F-Wilke/TekadeCarPhone/7SegFootprint.JPG

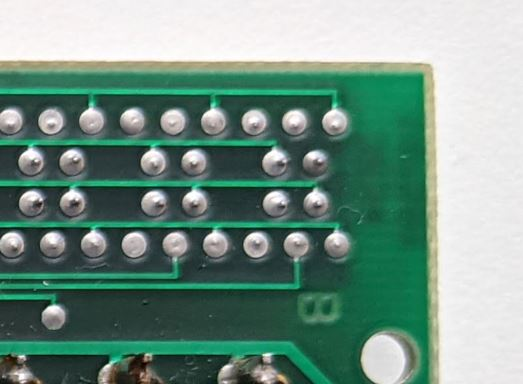
7SegFootprint.JPG
