F-Wilke/TekadeCarPhone/LayoutBM83.PNG

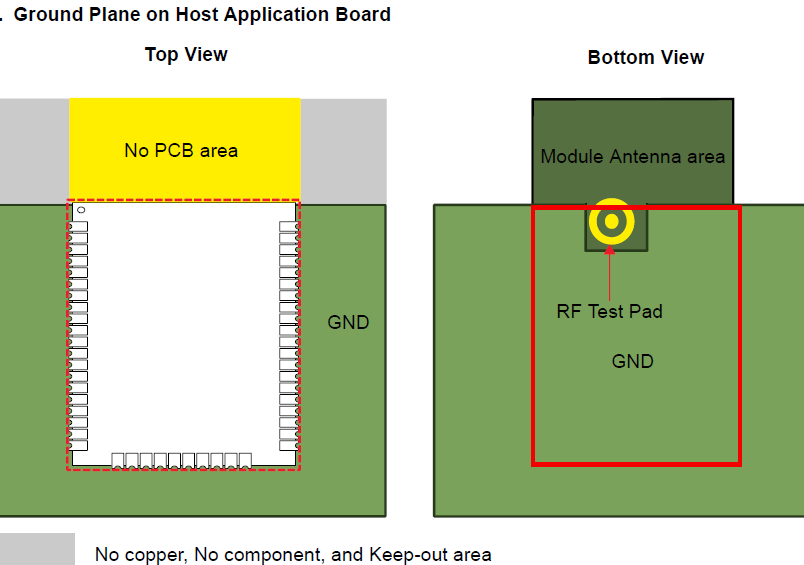
LayoutBM83.PNG
