F-Wilke/TekadeCarPhone/LayoutLM53635.PNG

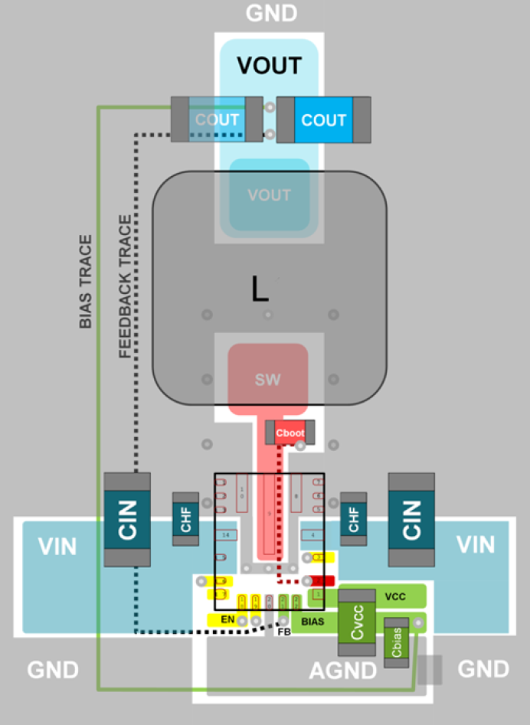
LayoutLM53635.PNG
