F-Wilke/TekadeCarPhone/LayoutLM74610.PNG

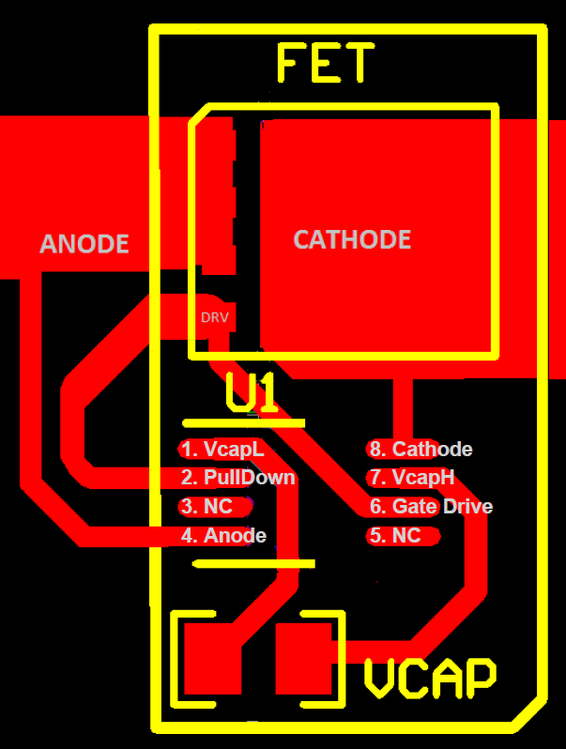
LayoutLM74610.PNG
