F-Wilke/TekadeCarPhone/LayoutTPS57114.PNG

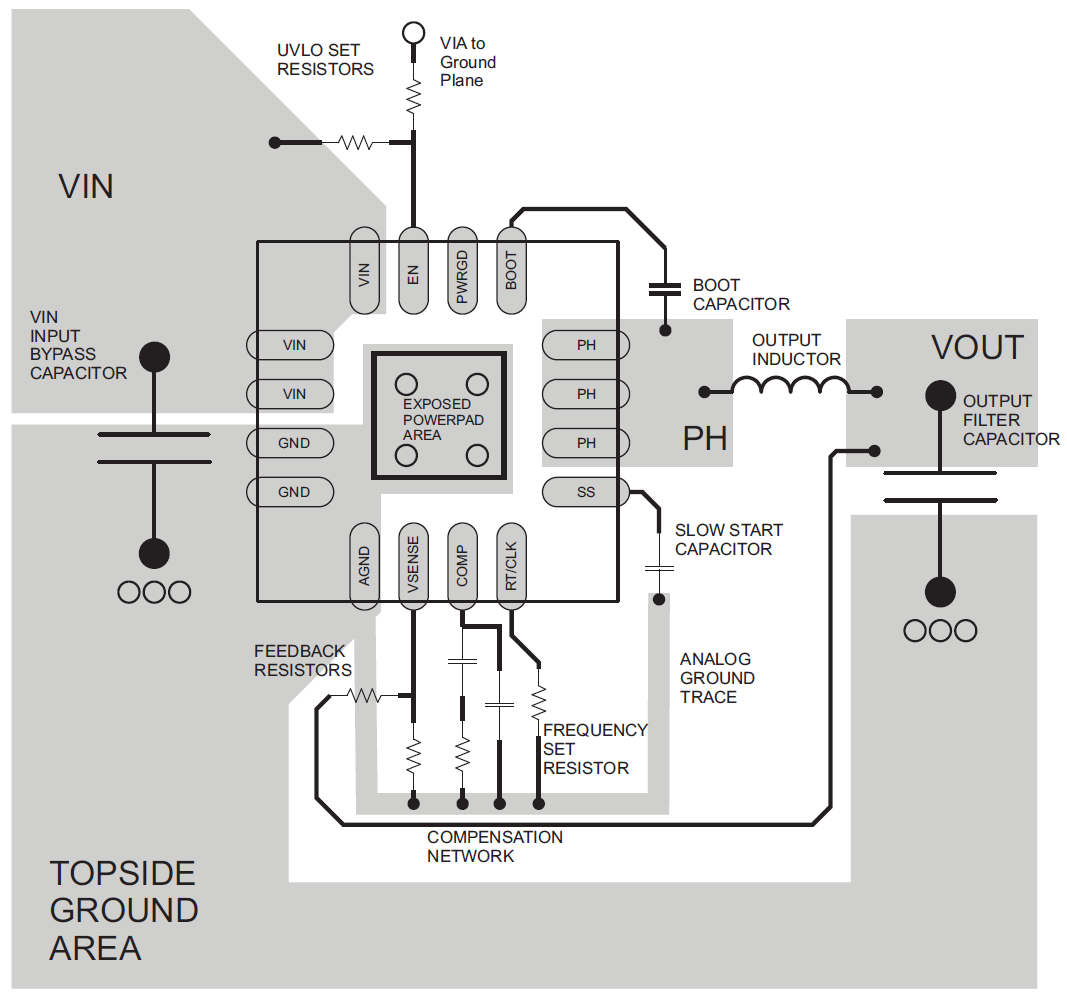
LayoutTPS57114.PNG
