F-Wilke/TekadeCarPhone/LayoutTPS62293.PNG

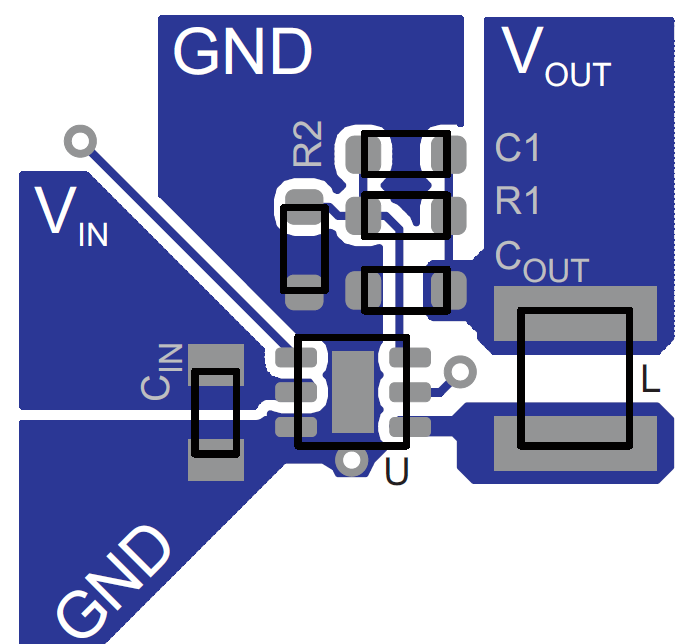
LayoutTPS62293.PNG
