F-Wilke/TekadeCarPhone/LDR_LED_UIBoard.png

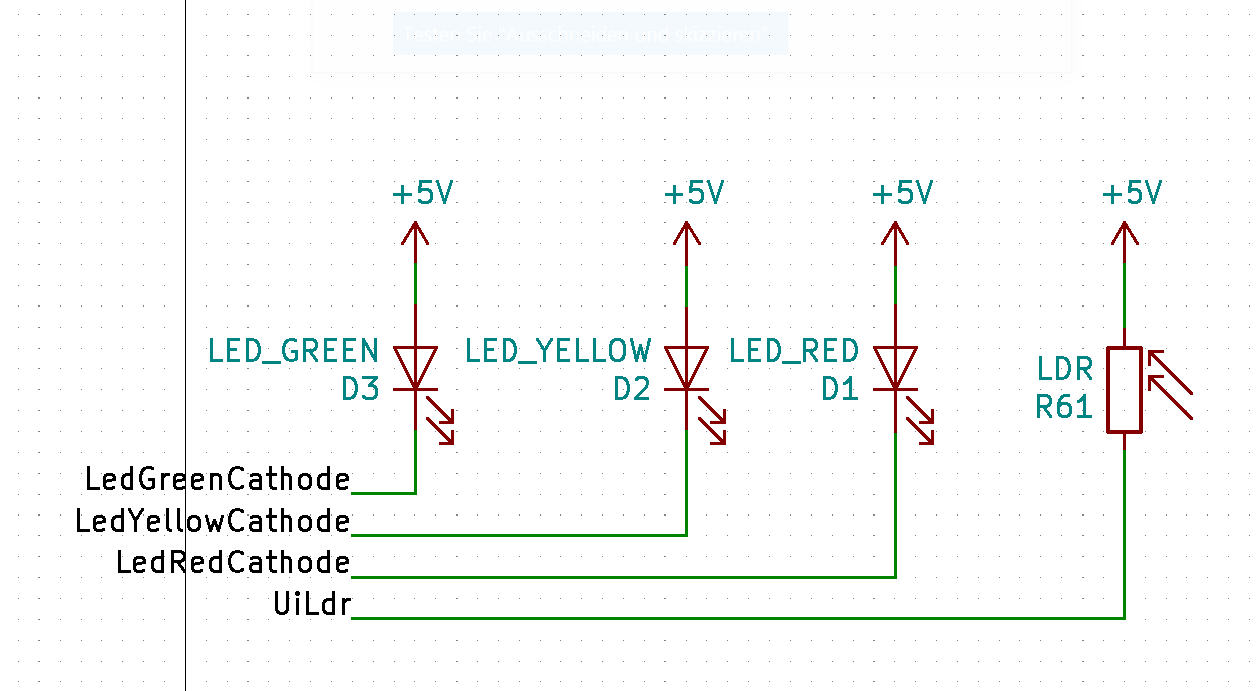
LDR_LED_UIBoard.png
