F-Wilke/TekadeCarPhone/RUNPG_GLOBALEN.JPG

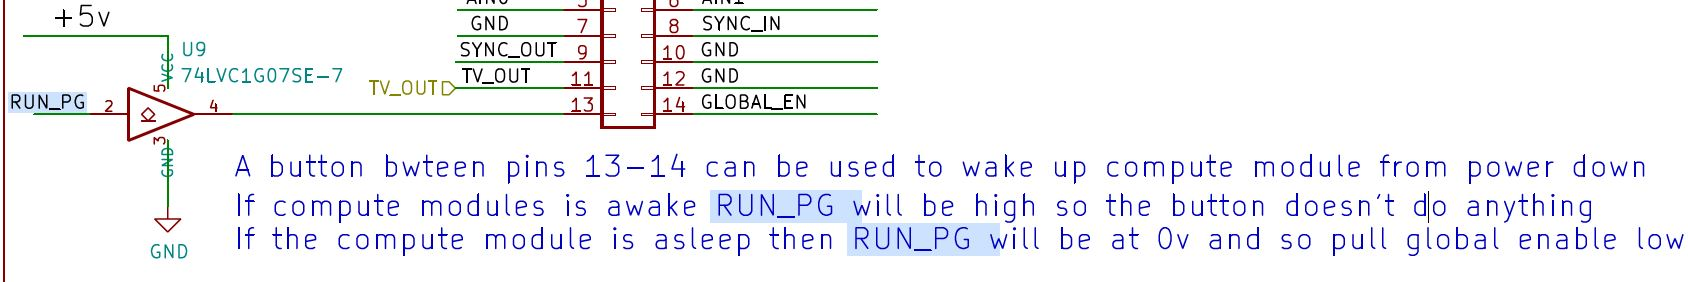
RUNPG_GLOBALEN.JPG
