F-Wilke/TekadeCarPhone/BOM/20220322 BOM TeKaDe Baseboard 5VEXT BM64.xlsx

Sheet: Vollständig
 |  |  |  |  |  |  |  |  | MOUSER |  |  |  | Gesamtpreis
Item | Qty | Description | Reference | Mfr | Mfr P/N | Case | Height | Qualification | Artikelnr | Available | 10er Preis | 1000er Preis | 10er | 1000er
1 | 1 | 4u7/16V/X7R/10% | C1 | Taiyo Yuden | EMK212AB7475KGHT | 805 |  | AEC-Q200 | 963-EMK212AB7475KGHT | 100k | 0.15 € | 0.06 € | 0.15 € | 0.06 €
2 | 17 | 100n/16V/X7R/10% | C2-C5, C10, C31-C33, C38, C40, C42, C71, C72, C74, C75, C77, C78 | WE | 885012205037 | 402 |  |  | 710-885012205037 | 196K | 0.02 € | 0.01 € | 0.29 € | 0.24 €
3 | 4 | 4n7/100V/X7R/10% | C6-C9 | Samsung | CL21B472KDCNNNC | 805 |  |  | 187-CL21B472KDCNNNC | 343k | 0.04 € | 0.03 € | 0.14 € | 0.13 €
4 | 4 | 10u/50V/X7R/10% | C13, C14, C18, C19 | Samsung | CL32B106KBJNNNF | 1210 |  |  | 187-CL32B106KBJNNNF | 1100 | 0.36 € | 0.18 € | 1.44 € | 0.70 €
5 | 2 | 1n/100V/X7R/10% | C15, C17 | Samsung | CL10B102KC8NNNC | 603 |  |  | 187-CL10B102KC8NNNC | 20k | 0.02 € | 0.01 € | 0.04 € | 0.02 €
6 | 1 | 220u/25V/POL/20% | C20 | KEMET | ESL227M035AG8AA | D8 x 3,5 Pin |  |  | 80-ESL227M035AG8AA | 825 | 0.19 € | 0.12 € | 0.19 € | 0.12 €
7 | 2 | 47u/10V/X5R/20% | C34, C37 | Taiyo Yuden | LMK316ABJ476ML-T | 1206 |  |  | 963-LMK316ABJ476ML-T | 15K | 0.28 € | 0.15 € | 0.57 € | 0.31 €
8 | 2 | 22u/10V/X5R/20% | C35, C36 | Murata | GRM21BR61A226ME51L | 805 |  |  | 81-GRM21BR61A226ME1L | 1500K | 0.17 € | 0.07 € | 0.34 € | 0.13 €
9 | 0 | NA | C39 |  |  | 603 |  |  |  |  |  |  | 0.00 € | 0.00 €
10 | 1 | 10u/6V3/X5R/20% | C41 | Taiyo Yuden | JMK107ABJ106MAHT | 603 |  | AEC-Q200 | 963-JMK107ABJ106MAHT | 127k | 0.07 € | 0.04 € | 0.07 € | 0.04 €
11 | 10 | 10p/50V/C0G/5% | C46, C47, C50, C51, C55, C56, C60, C61, C66, C69 | KEMET | C0402C100J5GACAUTO7411 | 402 |  | AEC-Q200 | 80-C0402C100J5GAUTLR | 72K | 0.06 € | 0.20 € | 0.58 € | 2.00 €
12 | 19 | 1u/6V3/X5R/10% | C43-C45, C48, C49, C52-C54, C57-C59, C62, C64, C65, C67, C68, C70, C73, C76 | Taiyo Yuden | JMK105BJ105KVHF | 402 |  | AEC-Q200 | 963-JMK105BJ105KVHF | 360k | 0.03 € | 0.02 € | 0.53 € | 0.30 €
13 | 1 | 2u2/6V3/X5R/10% | C63 | Taiyo Yuden | LMK107BJ225KAHT | 603 |  | AEC-Q200 | 963-LMK107BJ225KAHT | 30k | 0.06 € | 0.02 € | 0.06 € | 0.02 €
14 | 4 | 150R/100mW/1% | R1, R2, R4, R5 | Yageo | AC0603FR-7W150RL | 603 |  | AEC-Q200 | 603-AC0603FR-7W150RL | 2K | 0.04 € | 0.02 € | 0.16 € | 0.06 €
15 | 1 | 10k/100mW/1% | R3 | Yageo | AC0603FR-1010KL | 603 |  | AEC-Q200 | 603-AC0603FR-1010KL | 270K | 0.02 € | 0.01 € | 0.02 € | 0.01 €
16 | 7 | 22k/62,5mA/1% | R6-R11, R13 | Yageo | AC0402FR-1322KL | 402 |  | AEC-Q200 | 603-AC0402FR-1322KL | 94K | 0.01 € | 0.004 € | 0.10 € | 0.03 €
17 | 1 | 100k/62,5mA/1% | R12 | Yageo | AC0402FR-13100KL | 402 |  | AEC-Q200 | 603-AC0402FR-13100KL | 56K | 0.02 € | 0.004 € | 0.02 € | 0.004 €
18 | 1 | 15k/62,5mA/1% | R14 | Yageo | AC0402FR-0715KL | 402 |  | AEC-Q200 | 603-AC0402FR-0715KL | 5K | 0.01 € | 0.004 € | 0.01 € | 0.004 €
19 | 1 | 100R/62,5mA/1% | R15 | Yageo | AC0402FR-13100RL | 402 |  | AEC-Q200 | 603-AC0402FR-13100RL | 7K | 0.01 € | 0.003 € | 0.01 € | 0.003 €
20 | 2 | 47k/62,5mA/1% | R16, R19 | Yageo | AC0402FR-0747KL | 402 |  | AEC-Q200 | 603-AC0402FR-0747KL | 4K | 0.01 € | 0.003 € | 0.03 € | 0.01 €
21 | 3 | 1k/100mW/1% | R17, R18, R30 | Yageo | AC0603FR-071KL | 603 |  | AEC-Q200 | 603-AC0603FR-071KL | 43K | 0.03 € | 0.004 € | 0.08 € | 0.01 €
22 | 1 | 68R/125mW/1% | R23 | Yageo | AC0805FR-0768RL | 805 |  | AEC-Q200 | 603-AC0805FR-0768RL | 5K | 0.03 € | 0.01 € | 0.03 € | 0.01 €
23 | 2 | 150R/125mW/1% | R24, R26 | Yageo | AC0805FR-07150RL | 805 |  | AEC-Q200 | 603-AC0805FR-07150RL | 9K | 0.04 € | 0.01 € | 0.07 € | 0.01 €
24 | 6 | 10k/62,5mA/1% | R20-R22, R25, R44, R45 | Yageo | AC0402FR-1310KL | 402 |  | AEC-Q200 | 603-AC0402FR-1310KL | 12K | 0.02 € | 0.004 € | 0.12 € | 0.02 €
25 | 1 | 360R/100mW/1% | R27 | Yageo | AC0603FR-07360RL | 603 |  | AEC-Q200 | 603-AC0603FR-07360RL | 865 | 0.03 € | 0.01 € | 0.03 € | 0.01 €
26 | 0 | NA | R31-R34 |  |  | 402 |  |  |  |  |  |  | 0.00 € | 0.00 €
27 | 0 | NA | R35, R36, R38 |  |  | 603 |  |  |  |  |  |  | 0.00 € | 0.00 €
28 | 3 | 0R | R37, R39, R49 | Yageo | AC0603FR-070RL | 603 |  | AEC-Q200 | 603-AC0603FR-070RL | 154K | 0.01 € | 0.004 € | 0.04 € | 0.01 €
29 | 4 | 2k2/62,5mA/1% | R40-R43 | Yageo | AF0402FR-072K2L | 402 |  | AEC-Q200 | 603-AF0402FR-072K2L | 30K | 0.06 € | 0.01 € | 0.22 € | 0.04 €
30 | 1 | 4k7/62,5mA/1% | R46 | Yageo | AC0402FR-134K7L | 402 |  | AEC-Q200 | 603-AC0402FR-134K7L | 71K | 0.02 € | 0.004 € | 0.02 € | 0.004 €
31 | 1 | 1M/62,5mA/1% | R47 | Yageo | AC0402FR-071ML | 402 |  | AEC-Q200 | 603-AC0402FR-071ML | 157K | 0.02 € | 0.004 € | 0.02 € | 0.004 €
32 | 1 | 86k6/62,5mA/1% | R48 | Panasonic | ERJ-U02F8662X | 402 |  | AEC-Q200 | 667-ERJ-U02F8662X | 13K | 0.09 € | 0.02 € | 0.09 € | 0.02 €
33 | 1 | NTC/100k/1%/4250–4299K | TH1 | Panasonic | ERT-J1VR104FM | 603 |  | AEC-Q200 | 667-ERT-J1VR104FM | 640 | 0.23 € | 0.13 € | 0.23 € | 0.13 €
34 | 1 | Ferrit/470R/1A/0,2R | L1 | Taiyo Yuden | FBMH1608HM471-TV | 603 |  | AEC-Q200 | 963-FBMH1608HM471-TV | 3K | 0.10 € | 0.06 € | 0.10 € | 0.06 €
35 | 1 | CMF 1kOhm / 14mOhm / 6A | L2 | TDK | ACM1211-102-2PL-TL01 | 11x12mm | 6mm |  | 810-ACM12111022PLTL1 | 13K | 1.32 € | 1.04 € | 1.32 € | 1.04 €
36 | 1 | ATmega4809-AU | U1 | Microchip | ATMEGA4809-AUR | TQFP-48 |  |  | 556-ATMEGA4809-AUR | 2022-02-09 | 1.45 € | 1.30 € | 1.45 € | 1.30 €
37 | 3 | Optocouple 1Channel | U2, U3, U4 | Vishay | VOMA617A-4X001T | SOP-4 | 2,1mm |  | 78-VOMA617A-4X001T | 4K | 1.79 € | 0.92 € | 5.37 € | 2.75 €
38 | 1 | Reset IC | U5 | Diodes Inc. | APX803L-30SA-7 | SOT-23-3 |  |  | 621-APX803L-30SA-7 | 2600 | 0.36 € | 0.11 € | 0.36 € | 0.11 €
39 | 2 | CM4 Connector 3mm | U7 (needs 2x Connectors) | Hirose | DF40HC(3.0)-100DS-0.4V |  | 6,6mm incl. CM4 |  | 798-DF40HC30100DS451 | 2022-03-07 | 1.88 € | 1.27 € | 3.76 € | 2.54 € | clearance under CM4 1.5mm, mit 1,5mm hohen Verbinder 0 clearance
40 | 1 | 7Seg Line Decoder | U8 | TI | CD4514BM96 | SOIC-24 |  |  | 595-CD4514BM96 | 1280 | 0.76 € | 0.33 € | 0.76 € | 0.33 €
41 | 1 | 7Seg BCD Decoder | U9 | TI | CD4511BPWR | TSSOP-16 |  |  | 595-CD4511BPWR | 7000 | 0.64 € | 0.31 € | 0.64 € | 0.31 €
42 | 4 | ULN2003F12FN-7 | U10-U13 | Diodes Inc. | ULN2003F12FN-7 | UDFN3030-10 |  |  | 621-ULN2003F12FN-7 | 2022-07-22 | 0.35 € | 0.16 € | 1.42 € | 0.64 €
43 | 1 | MAX98089ETN+ | U14 | Maxim Integrated | MAX98089ETN+ | QFN-56 | 0,8mm |  | 700-MAX98089ETN+ | 3K | 3.53 € | 2.97 € | 3.53 € | 2.97 €
44 | 2 | SN74LV1T126 | U15, U16 | TI | SN74LV1T126DBVRG4 | SOT-23-5 |  |  | 595-SN74LV1T126DBVRG | 1800 | 0.42 € | 0.19 € | 0.84 € | 0.38 €
45 | 0 | SN74LV1T126 | U15, U16 alternative | TI | SN74LV1T126DBVR | SOT-23-5 |  |  | 595-SN74LV1T126DBVR | 2022-09-05 | 0.35 € | 0.18 € | 0.00 € | 0.00 €
46 | 1 | BT Module BM64 | U17 | Microchip | BM64SPKS1MC2-0002AA | BM64 | 2,5mm |  | 579-BM64SPKS1MC202AA | 13 | 13.89 € | 13.89 € | 13.89 € | 13.89 €
47 | 1 | RTC | U18 | NXP | PCF85063ATT/AJ | TSSOP8 | 1,75mm |  | 771-PCF85063ATT/AJ | 2022-03-11 | 0.73 € | 0.42 € | 0.73 € | 0.42 €
48 | 2 | SMBJ28AQ-13-F | D1, D3 | Diodes Inc. | SMBJ28AQ-13-F | SMB |  | AEC-Q101 | 621-SMBJ28AQ-13-F | 3700 | 0.36 € | 0.14 € | 0.73 € | 0.28 €
49 | 3 | SMBJ14AQ-13-F | D2, D4, D14 | Diodes Inc. | SMBJ14AQ-13-F | SMB |  | AEC-Q101 | 621-SMBJ14AQ-13-F | 2022-08-10 | 0.28 € | 0.09 € | 0.84 € | 0.28 €
50 | 3 | 1N4148WQ-7-F | D5, D6, D15 | Diodes Inc. | SMMSD4148T1G | SOD-123F |  | AEC-Q101 | 863-SMMSD4148T1G | 189K | 0.29 € | 0.11 € | 0.86 € | 0.33 €
51 | 1 | Zener 5,1V 350mW | D7 | Diodes Inc. | BZX84B5V1-7-F | SOT-23-3 |  | AEC-Q101 | 621-BZX84B5V1-7-F | 10K | 0.17 € | 0.04 € | 0.17 € | 0.04 €
52 | 1 | LED_GRN | D8 | Wurth Elektronik | 150060VS75000 | 603 |  |  | 710-150060VS75000 | 140K | 0.13 € | 0.09 € | 0.13 € | 0.09 €
53 | 1 | LED_BLUE | D9 | Wurth Elektronik | 150060BS75000 | 603 |  |  | 710-150060BS75000 | 70K | 0.14 € | 0.09 € | 0.14 € | 0.09 €
54 | 1 | LED_RED | D10 | Wurth Elektronik | 150060RS75000 | 603 |  |  | 710-150060RS75000 | 92K | 0.13 € | 0.09 € | 0.13 € | 0.09 €
55 | 1 | BAT54C | D11 | Nexperia | BAT54C,215 | SOT-23-3 | 1,1mm | AEC-Q101 | 771-BAT54C-T/R | 174K | 0.11 € | 0.03 € | 0.11 € | 0.03 €
56 | 2 | Zener 12V 100mA | D12, D13 | Diodes Inc. | BZX84B12-7-F | SOT-23-3 |  | AEC-Q101 | 621-BZX84B12-7-F | 13K | 0.17 € | 0.04 € | 0.35 € | 0.08 €
57 | 1 | P MOSFET / 20V / 1,5A / Logiclevel | Q1 | Infineon | BSS314PEH6327XTSA1 | SOT-23-3 |  | AEC-Q101 | 726-BSS314PEH6327XTS | 500 | 0.29 € | 0.10 € | 0.29 € | 0.10 €
58 | 1 | N MOSFET / 30V / 2A | Q2 | Vishay | SI2316BDS-T1-GE3 | SOT-23-3 |  |  | 781-SI2316BDS-T1-GE3 | 50K | 0.44 € | 0.26 € | 0.44 € | 0.26 €
59 | 1 | Crystal 32.768kHz | Y1 | TXC | 9HT12-32.768KDZY-T | 2Pin 1.6x1.0mm | 0,5mm |  | 717-9HT12-32.76KDZYT | 9K | 0.96 € | 0.66 € | 0.96 € | 0.66 €
60 | 1 | OSC 12.2880MHz | Y2 | Wurth Elektronik | 830208220101 | 2.5x2.0mm | 1,0mm |  | 710-830208220101 | 3K | 1.43 € | 1.12 € | 1.43 € | 1.12 €
61 | 1 | Audio VERT 20 CKT 2 ROW P2,00 | J1 | Molex | 34825-0200 | MINI50 |  | automotive | 538-34825-0200 | 300 | 1.91 € | 1.24 € | 1.91 € | 1.24 €
62 | 0 | NA | J2 |  |  |  |  |  |  |  |  |  | 0.00 € | 0.00 €
63 | 1 | Signal HOR 2 CKT 1 ROW P1,25 | J3 | Molex | 53048-0250 | PicoBlade | 3,5mm |  | 538-53048-0250 | 2800 | 0.50 € | 0.31 € | 0.50 € | 0.31 €
64 | 1 | Pinsocket VERT 16 CKT 2 ROW P2,54 | J4 | Amphenol FCI | 68683-308LF |  | 7mm |  | 649-68683-308LF | 10 | 1.93 € | 1.32 € | 1.93 € | 1.32 €
65 | 1 | 8pol 5mm 1,5² Connector Push | J5 | Phoenix Contact | 1792928 (PTS 1,5/8-5,0-H) |  |  |  | 651-1792928 | 1351 | 2.24 € | 2.24 € | 2.24 € | 2.24 €
66 | 1 | Pinsocket VERT 30 CKT 2 ROW P2,54 | J6 | Amphenol FCI | 68683-315LF |  | 7mm |  | 649-68683-315LF | 300 | 3.45 € | 2.37 € | 3.45 € | 2.37 €
67 | 1 | Lock HOR 3 CKT 1 ROW P1,25 | J7 | Molex | 53048-0350 | PicoBlade | 3,5mm |  | 538-53048-0350 | 11K | 0.59 € | 0.40 € | 0.59 € | 0.40 €
68 | 0 | NA | J8 |  |  |  |  |  |  |  |  |  | 0.00 € | 0.00 €
69 | 0 | NA | J9 |  |  |  |  |  |  |  |  |  | 0.00 € | 0.00 €
70 | 1 | Battery | BT1 | Linx Technologies | BAT-HLD-003-SMT | CR2032 SMD | 3,9mm |  | 712-BAT-HLD-003-SMT | 4300 | 0.271 | 0.205 | 0.271 | 0.205
 |  |  |  |  |  |  |  |  |  |  |  |  | 57.31 € | 42.72 €

Sheet: An Fertiger
Item | Qty | Description | Reference | Mfr | Mfr P/N | Case | Qualification
1 | 1 | 4u7/16V/X7R/10% | C1 | Taiyo Yuden | EMK212AB7475KGHT | 805 | AEC-Q200
2 | 17 | 100n/16V/X7R/10% | C2-C5, C10, C31-C33, C38, C40, C42, C71, C72, C74, C75, C77, C78 | WE | 885012205037 | 402
3 | 4 | 4n7/100V/X7R/10% | C6-C9 | Samsung | CL21B472KDCNNNC | 805
4 | 4 | 10u/50V/X7R/10% | C13, C14, C18, C19 | Samsung | CL32B106KBJNNNF | 1210
5 | 2 | 1n/100V/X7R/10% | C15, C17 | Samsung | CL10B102KC8NNNC | 603
6 | 1 | 220u/25V/POL/20% | C20 | KEMET | ESL227M035AG8AA | D8 x 3,5 Pin
7 | 2 | 47u/10V/X5R/20% | C34, C37 | Taiyo Yuden | LMK316ABJ476ML-T | 1206
8 | 2 | 22u/10V/X5R/20% | C35, C36 | Murata | GRM21BR61A226ME51L | 805
9 | 0 | NA | C39
10 | 1 | 10u/6V3/X5R/20% | C41 | Taiyo Yuden | JMK107ABJ106MAHT | 603 | AEC-Q200
11 | 10 | 10p/50V/C0G/5% | C46, C47, C50, C51, C55, C56, C60, C61, C66, C69 | KEMET | C0402C100J5GACAUTO7411 | 402 | AEC-Q200
12 | 19 | 1u/6V3/X5R/10% | C43-C45, C48, C49, C52-C54, C57-C59, C62, C64, C65, C67, C68, C70, C73, C76 | Taiyo Yuden | JMK105BJ105KVHF | 402 | AEC-Q200
13 | 1 | 2u2/6V3/X5R/10% | C63 | Taiyo Yuden | LMK107BJ225KAHT | 603 | AEC-Q200
14 | 4 | 150R/100mW/1% | R1, R2, R4, R5 | Yageo | AC0603FR-7W150RL | 603 | AEC-Q200
15 | 1 | 10k/100mW/1% | R3 | Yageo | AC0603FR-1010KL | 603 | AEC-Q200
16 | 7 | 22k/62,5mA/1% | R6-R11, R13 | Yageo | AC0402FR-1322KL | 402 | AEC-Q200
17 | 1 | 100k/62,5mA/1% | R12 | Yageo | AC0402FR-13100KL | 402 | AEC-Q200
18 | 1 | 15k/62,5mA/1% | R14 | Yageo | AC0402FR-0715KL | 402 | AEC-Q200
19 | 1 | 100R/62,5mA/1% | R15 | Yageo | AC0402FR-13100RL | 402 | AEC-Q200
20 | 2 | 47k/62,5mA/1% | R16, R19 | Yageo | AC0402FR-0747KL | 402 | AEC-Q200
21 | 3 | 1k/100mW/1% | R17, R18, R30 | Yageo | AC0603FR-071KL | 603 | AEC-Q200
22 | 1 | 68R/125mW/1% | R23 | Yageo | AC0805FR-0768RL | 805 | AEC-Q200
23 | 2 | 150R/125mW/1% | R24, R26 | Yageo | AC0805FR-07150RL | 805 | AEC-Q200
24 | 6 | 10k/62,5mA/1% | R20-R22, R25, R44, R45 | Yageo | AC0402FR-1310KL | 402 | AEC-Q200
25 | 1 | 360R/100mW/1% | R27 | Yageo | AC0603FR-07360RL | 603 | AEC-Q200
26 | 0 | NA | R31-R34
27 | 0 | NA | R35, R36, R38
28 | 3 | 0R | R37, R39, R49 | Yageo | AC0603FR-070RL | 603 | AEC-Q200
29 | 4 | 2k2/62,5mA/1% | R40-R43 | Yageo | AF0402FR-072K2L | 402 | AEC-Q200 | F
30 | 1 | 4k7/62,5mA/1% | R46 | Yageo | AC0402FR-134K7L | 402 | AEC-Q200
31 | 1 | 1M/62,5mA/1% | R47 | Yageo | AC0402FR-071ML | 402 | AEC-Q200
32 | 1 | 86k6/62,5mA/1% | R48 | Panasonic | ERJ-U02F8662X | 402 | AEC-Q200
33 | 1 | NTC/100k/1%/4250–4299K | TH1 | Panasonic | ERT-J1VR104FM | 603 | AEC-Q200
34 | 1 | Ferrit/470R/1A/0,2R | L1 | Taiyo Yuden | FBMH1608HM471-TV | 603 | AEC-Q200
35 | 1 | CMF 1kOhm / 14mOhm / 6A | L2 | TDK | ACM1211-102-2PL-TL01 | 11x12mm
36 | 1 | ATmega4809-AU | U1 | Microchip | ATMEGA4809-AUR | TQFP-48
37 | 3 | Optocouple 1Channel | U2, U3, U4 | Vishay | VOMA617A-4X001T | SOP-4
38 | 1 | Reset IC | U5 | Diodes Inc. | APX803L-30SA-7 | SOT-23-3
39 | 2 | CM4 Connector 3mm | U7 (needs 2x Connectors) | Hirose | DF40HC(3.0)-100DS-0.4V
40 | 1 | CD4514B | U8 | TI | CD4514BM96 | SOIC-24
41 | 1 | CD4511B | U9 | TI | CD4511BPWR | TSSOP-16
42 | 4 | ULN2003F12FN-7 | U10-U13 | Diodes Inc. | ULN2003F12FN-7 | UDFN3030-10
43 | 1 | MAX98089ETN+ | U14 | Maxim Integrated | MAX98089ETN+ | QFN-56
44 | 2 | SN74LV1T126 | U15, U16 | TI | SN74LV1T126DBVRG4 | SOT-23-5
46 | 1 | BM64 BT Module | U17 | Microchip | BM64SPKS1MC2-0002AA | BM64
47 | 1 | PCF85063A | U18 | NXP | PCF85063ATT/AJ | TSSOP8 | AEC-Q101
48 | 2 | SMBJ28AQ-13-F | D1, D3 | Diodes Inc. | SMBJ28AQ-13-F | SMB | AEC-Q101
49 | 3 | SMBJ14AQ-13-F | D2, D4, D14 | Diodes Inc. | SMBJ14AQ-13-F | SMB | AEC-Q101
50 | 3 | 1N4148WQ-7-F | D5, D6, D15 | Diodes Inc. | SMMSD4148T1G | SOD-123F | AEC-Q101
51 | 1 | Zener 5,1V 350mW | D7 | Diodes Inc. | BZX84B5V1-7-F | SOT-23-3
52 | 1 | LED_GRN | D8 | Wurth Elektronik | 150060VS75000 | 603
53 | 1 | LED_BLUE | D9 | Wurth Elektronik | 150060BS75000 | 603
54 | 1 | LED_RED | D10 | Wurth Elektronik | 150060RS75000 | 603 | AEC-Q101
55 | 1 | BAT54C | D11 | Nexperia | BAT54C,215 | SOT-23-3 | AEC-Q101
56 | 2 | Zener 12V 100mA | D12, D13 | Diodes Inc. | BZX84B12-7-F | SOT-23-3 | AEC-Q101
57 | 1 | P MOSFET / 20V / 1,5A / Logiclevel | Q1 | Infineon | BSS314PEH6327XTSA1 | SOT-23-3
58 | 1 | N MOSFET / 30V / 2A | Q2 | Vishay | SI2316BDS-T1-GE3 | SOT-23-3
59 | 1 | Crystal 32.768kHz | Y1 | TXC | 9HT12-32.768KDZY-T | 2Pin 1.6x1.0mm | automotive
60 | 1 | OSC 12.2880MHz | Y2 | Wurth Elektronik | 830208220101
61 | 1 | Audio VERT 20 CKT 2 ROW P2,00 | J1 | Molex | 34825-0200 | MINI50
62 | 0 | NA | J2
63 | 1 | Signal HOR 2 CKT 1 ROW P1,25 | J3 | Molex | 53048-0250 | PicoBlade
64 | 1 | Pinsocket VERT 16 CKT 2 ROW P2,54 | J4 | Amphenol FCI | 68683-308LF
65 | 1 | 8pol 5mm 1,5² Connector Push | J5 | Phoenix Contact | 1792928 (PTS 1,5/8-5,0-H)
66 | 1 | Pinsocket VERT 30 CKT 2 ROW P2,54 | J6 | Amphenol FCI | 68683-315LF
67 | 1 | Lock HOR 3 CKT 1 ROW P1,25 | J7 | Molex | 53048-0350 | PicoBlade
68 | 0 | NA | J8
69 | 0 | NA | J9
70 | 1 | Battery | BT1 | Linx Technologies | BAT-HLD-003-SMT | CR2032 SMD
