F-Wilke/TekadeCarPhone/BOM/20211210 BOM TeKaDe Baseboard.xlsx

Sheet: Tabelle1
 |  |  |  |  |  |  |  |  | MOUSER |  |  |  | FARNELL |  |  | Gesamtpreis
Item | Qty | Description | Reference | Mfr | Mfr P/N | Case | Height | Qualification | Artikelnr | Available | 10er Preis | 1000er Preis | Artikelnr | 10er Preis | 1000er Preis | 10er | 1000er
 | 2 | 4u7/16V/X7R | C1, C16 |  |  | 805
 | 17 | 100n/16V/X7R | C2-C4, C21, C23, C31-C33, C38, C40, C42, C71, C72, C74, C75, C77, C78 | WE | 885012205037 | 402 |  |  | 710-885012205037 | 230000 | 0.02 € | 0.01 €
 | 4 | 4n7/100V/X7R | C6-C9 |  |  | 805
 | 2 | 47n/50V/X7R | C10, C12 |  |  | 603
 | 2 | 10u/50V/X5R | C5, C11 |  |  | 1206
 | 5 | 10u/50V/X7R | C13, C14, C18, C19, C30 |  |  | 1210
 | 3 | 1n/100V/X7R | C15, C17, C27 |  |  | 603
 | 1 | 470n/25V/X5R | C20 |  |  | 603
 | 1 | 2u2/50V/X5R | C22 |  |  | 805
 | 4 | 22u/10V/X5R | C24, C25, C35, C36 |  |  | 805
 | 1 | 47u/10V/X7R | C26 |  |  | 1210
 | 2 | 4u7/50V/X7R | C28, C29 |  |  | 1206
 | 2 | 47u/10V/X5R | C34, C37 |  |  | 1206
 | 1 | 10u/6V3/X5R | C41 |  |  | 603
 | 10 | 10p/50V/C0G | C46, C47, C50, C51, C55, C56, C60, C61, C66, C69 | KEMET | C0402C100J5GACAUTO7411 | 402 |  |  | 80-C0402C100J5GAUTLR | 74000 | 0.06 € | 0.20 €
 | 19 | 1u/6V3/X5R | C43-C45, C48, C49, C52-C54, C57-C59, C62, C64, C65, C67, C68, C70, C73, C76 | Taiyo Yuden | JMK105BJ105KV-F | 402 |  |  | 963-JMK105BJ105KV-F | 3M | 0.02 € | 0.01 €
 | 1 | 2u2/6V3/X5R | C63 |  |  | 603
 | 0 | NA | C39 |  |  | 603
 | 4 | 150R/1% | R1, R2, R4, R5 |  |  | 603
 | 1 | 10k/1% | R3 |  |  | 603
 | 7 | 22k/1% | R6-R11, R13 |  |  | 402
 | 4 | 100k/1% | R12, R19, R27, R28 |  |  | 402
 | 1 | 15k | R14 |  |  | 402
 | 1 | 100R/1% | R15 |  |  | 402
 | 1 | 47k/1% | R16 |  |  | 402
 | 2 | 2k2/5%/250mW | R17, R18 |  |  | 603
 | 1 | 30k1/1% | R23 |  |  | 402
 | 1 | 2k/1% | R24 |  |  | 402
 | 6 | 10k/1% | R20-R22, R25, R44, R45 |  |  | 402
 | 2 | 20k/1% | R26, R29 |  |  | 402
 | 1 | 1k/1% | R30 |  |  | 603
 | 2 | 0R | R37, R39 |  |  | 603
 | 4 | 2k2/1% | R40-R43 |  |  | 402
 | 1 | 4k7/1% | R46 |  |  | 402
 | 1 | 1M/1% | R47 |  |  | 402
 | 1 | 86k6/1% | R48 |  |  | 402
 | 0 | NA | R31-R34 |  |  | 402
 | 0 | NA | R35, R36, R38 |  |  | 603
 | 1 | NTC/100k/1%/4250–4299K | TH1 |  |  | 603
 | 1 | Ferrit/470R/1A/0,2R | L1 |  |  | 603
 | 1 | CMF 1kOhm / 14mOhm / 6A | L2 | TDK | ACM1211-102-2PL-TL01 | 11x12mm | 6mm |  | 810-ACM12111022PLTL1 | 17500 | 1.32 € | 1.04 €
 | 1 | 2u2 / 9mOhm / 14A | L3 | Vishay | IHLP3232DZER2R2M11 | 3232 | 4mm |  | 70-IHLP3232DZER2R2M1 | 2400 | 0.85 € | 0.53 €
 | 1 | 2u2 / 25mOhm / 6,75A | LF1 | Vishay | IHLP2020CZER2R2M11 | 2020 | 3mm |  | 70-IHLP2020CZER2R2M1 | 7500 | 0.72 € | 0.46 €
 | 1 | ATmega4809-AU | U1 | Microchip | ATMEGA4809-AUR | TQFP-48 |  |  | 556-ATMEGA4809-AUR | 630 | 1.45 € | 1.30 €
 | 2 | Optocouple 1Channel | U2, U3 | Vishay | VOMA617A-4X001T | SOP-4 | 2,1mm |  | 78-VOMA617A-4X001T | 2950 | 1.74 € | 0.92 €
 | 1 | LM53635LQRNL*Q1 | U4 | TI | LM53635LQRNLTQ1 | VQFN-HR |  |  | 595-LM53635LQRNLTQ1 | 2023-02-02 | 5.02 € | 3.96 € |  | Verschiedene Alternativen vorhanden (nicht Pinkompatibel)
 | 1 | Shunt Adj Ref 1% / 20V / 80mA | U5 | TI | TLVH431AQDBVRQ1 | SOT-23-5 |  | AEC-Q100 | 595-TLVH431AQDBVRQ1 | 2022-09-05 | 0.68 € | 0.33 €
 | 0 | Shunt Adj Ref .5% / 20V / 80mA | U5 alternative | TI | TLVH431BQDBVRQ1 | SOT-23-5 |  | AEC-Q100 | 595-TLVH431BQDBVRQ1 | 249 | 0.89 € | 0.45 €
 | 0 | Shunt Adj Ref .25% / 36V / 80mA | U5 alternative | STMicroelectronics | TL1431AIYDT | SO-8 |  | AEC-Q100 | 511-TL1431AIYDT | 6000 | 0.49 € | 0.26 € |  | Achtung anderer Footprint und Widerstandsteiler muss entsprechend angepasst werden
 | 1 | LM74610-Q1 | U6 | TI | LM74610QDGKRQ1 | VSSOP (8) |  | AEC-Q100 | 595-LM74610QDGKRQ1 | 2023-02-02 | 2.08 € | 1.13 € |  | Verschiedene Alternativen vorhanden (nicht Pinkompatibel)
 | 2 | CM4 Connector 3mm | U7 | Hirose | DF40HC(3.0)-100DS-0.4V |  | 6,6mm incl. CM4 |  | 798-DF40HC30100DS451 | 2021-12-23 | 1.82 € | 1.23 €
 | 0 | CM4 Connector 1,5mm | U7 alternative | Hirose | DF40C-100DS-0.4V |  | 5,1mm incl. CM4 |  | 798-DF40C100DS0.4V51 | 27 weeks | 1.25 € | 0.83 €
 | 1 | 7Seg Line Decoder | U8 | TI | CD4514BM96 | SOIC-24 |  |  | 595-CD4514BM96 | 3870 | 0.69 € | 0.33 €
 | 1 | 7Seg BCD Decoder | U9 | TI | CD4511BPWR | TSSOP-16 |  |  | 595-CD4511BPWR | 2000 | 0.41 € | 0.18 €
 | 4 | ULN2003F12FN-7 | U10-U13 | Diodes Inc. | ULN2003F12FN-7 | UDFN3030-10 |  |  | 621-ULN2003F12FN-7 | 2022-03-28 | 0.35 € | 0.16 € |  | Verschiedene Alternativen vorhanden (vermutlich nicht Pinkompatibel)
 | 1 | MAX98089ETN+ | U14 | Maxim Integrated | MAX98089ETN+ | QFN-56 |  |  | 700-MAX98089ETN+ | 12000 | 3.53 € | 2.97 €
 | 2 | SN74LV1T126 | U15, U16 | TI | SN74LV1T126DBVRG4 | SOT-23-5 |  |  | 595-SN74LV1T126DBVRG | 2021-12-02 | 0.35 € | 0.18 €
 | 0 | SN74LV1T126 | U15, U16 alternative | TI | SN74LV1T126DBVR | SOT-23-5 |  |  | 595-SN74LV1T126DBVR | 2022-09-05 | 0.35 € | 0.18 €
 | 1 | BT Module BM83 | U17 | Microchip | BM83SM1-00TA | BM83SM1 | 2,5mm |  | 579-BM83SM1-00TA | 2022-10-31 | 9.80 € | 9.80 €
 | 1 | RTC | U18 | NXP | PCF85063ATT/AJ | TSSOP8 |  |  | 771-PCF85063ATT/AJ | 149 | 0.73 € | 0.42 €
 | 2 | SMBJ28AQ-13-F | D1, D3 | Diodes Inc. | SMBJ28AQ-13-F | SMB |  | AEC-Q101 | 621-SMBJ28AQ-13-F | 4000 | 0.36 € | 0.14 €
 | 2 | SMBJ14AQ-13-F | D2, D4 | Diodes Inc. | SMBJ14AQ-13-F | SMB |  | AEC-Q101 | 621-SMBJ14AQ-13-F | 50 | 0.28 € | 0.09 €
 | 2 | 1N4148WQ-7-F | D5, D6 | Diodes Inc. | 1N4148WQ-7-F | SOD-123F |  | AEC-Q101 | 621-1N4148WQ-7-F | 2022-12-30 | 0.18 € | 0.04 € |  | Verschiedene Alternativen vorhanden (Pinkompatibel)
 | 1 | MMSZ5245BQ-7-F | D7 | Diodes Inc. | MMSZ5245BQ-7-F | SOD-123 |  | AEC-Q101 | 621-MMSZ5245BQ-7-F | 38 weeks | 0.17 € | 0.04 € |  | Verschiedene Alternativen vorhanden (Pinkompatibel)
 | 1 | LED_GRN | D8 | Wurth Elektronik | 150060VS75000 | 603 |  |  | 710-150060VS75000 | 120000 | 0.13 € | 0.09 €
 | 1 | LED_BLUE | D9 | Wurth Elektronik | 150060BS75000 | 603 |  |  | 710-150060BS75000 | 39000 | 0.14 € | 0.09 €
 | 1 | LED_RED | D10 | Wurth Elektronik | 150060RS75000 | 603 |  |  | 710-150060RS75000 | 180000 | 0.13 € | 0.09 €
 | 1 | BAT54C | D11 | Nexperia | BAT54C,215 | SOT-23-3 |  | AEC-Q101 | 771-BAT54C-T/R | 81000 | 0.11 € | 0.03 €
 | 1 | P MOSFET / 20V / 1,5A | Q1 | Infineon | BSS314PEH6327XTSA1 | SOT-23-3 |  | AEC-Q101 | 726-BSS314PEH6327XTS | 12280 | 0.29 € | 0.10 €
 | 1 | N MOSFET / 40V / 130A | Q2 | OnSemi | NVMFS5C442NL | SO-8FL |  | AEC-Q101 | 863-NVMFS5C442NLFT1G | 2021-11-24 | 0.75 € | 0.38 € |  | Verschiedene Alternativen vorhanden (eventuell Pinkompatibel)
 | 0 | N MOSFET / 40V / 75A | Q2 alternative | Vishay | SQJ422EP-T1_GE3 | SO-8L |  | AEC-Q101 | 781-SQJ422EP-T1_GE3 | 2022-06-03
 | 1 | N MOSFET / 60V / 4A | Q3 | Vishay | SQ2362ES-T1_GE3 | SOT-23 |  | AEC-Q101 | 78-SQ2362ES-T1_GE3 | 726 | 0.42 € | 0.19 € |  | Verschiedene Alternativen vorhanden (eventuell Pinkompatibel)
 | 0 | N MOSFET / 60V / 4A | Q3 alternative | Vishay | SQ2360EES-T1-GE3 | SOT-23 |  | AEC-Q101 | 78-SQ2360EES-T1-GE3 | ABGEKÜNDIGT
 | 1 | P MOSFET / 60V / 50A | Q4 | Vishay | SQD50P06-15L_GE3 | TO-252 |  | AEC-Q101 | 78-SQD50P06-15L_GE3 | 28 weeks | 1.91 € | 1.16 € |  | Verschiedene Alternativen vorhanden (eventuell Pinkompatibel)
 | 0 | P MOSFET / 60V / 30A | Q4 alternative | Vishay | SQJ461EP-T1_GE3 | SO-8L |  | AEC-Q101 | 78-SQJ461EP-T1_GE3 | 2022-05-11
 | 1 | Crystal 32.768kHz | Y1 | TXC | 9HT12-32.768KDZY-T | 2Pin 1.6x1.0mm |  |  | 717-9HT12-32.76KDZYT | 1200 | 0.96 € | 0.66 €
 | 1 | Audio VERT 20 CKT 2 ROW P2,00 | J1 | Molex | 34825-0200 | MINI50 |  | automotive | 538-34825-0200 | 300 | 1.91 € | 1.24 €
 | 0 | ISP 3 CKT 1 ROW P2,54 | J2
 | 1 | Signal HOR 2 CKT 1 ROW P1,25 | J3 | Molex | 53048-0250 | PicoBlade | 3,5mm |  | 538-53048-0250 | 3400 | 0.50 € | 0.31 €
 | 1 | Pinsocket VERT 16 CKT 2 ROW P2,54 | J4 | Amphenol FCI | 68683-308LF |  | 7mm |  | 649-68683-308LF | 2021-12-27 | 1.93 € | 1.32 € |  | Verschiedene Alternativen vorhanden (Pinkompatibel)
 | 1 | Power VERT 4 CKT 1 ROW P2,54 | J5 | Molex | 31101-0040 | H-DAC 64 |  | automotive | 538-31101-0040 | 440 | 2.49 € | 1.63 €
 | 1 | Pinsocket VERT 30 CKT 2 ROW P2,54 | J6 | Amphenol FCI | 68683-315LF |  | 7mm |  | 649-68683-315LF | 300 | 3.45 € | 2.37 €
 | 1 | Lock HOR 3 CKT 1 ROW P1,25 | J7 | Molex | 53048-0350 | PicoBlade | 3,5mm |  | 538-53048-0350 | 12800 | 0.59 € | 0.40 €
 | 1 | Battery | BT1 | Linx Technologies | BAT-HLD-005-THM | CR2032 THT | 3,6mm |  | 712-BAT-HLD-005-THM | 4600 | 0.27 € | 0.20 €
 | 0 | Battery | BT1 | Linx Technologies | BAT-HLD-003-SMT | CR2032 SMD | 3,9mm |  | 712-BAT-HLD-003-SMT | 4500 | 0.27 € | 0.20 €

Sheet: Tabelle2
Item | Qty | Description | Reference | Mfr | Mfr P/N | Case
1 | 6 | 100n 50V X7R | C1, C13, C19, C23, C27, C29 | Yageo | CC0603KRX7R9BB104 | 603
2 | 1 | 10u 6V3 X5R | C3 | KEMET | C0805C106K9PACTU | 805
3 | 3 | 1n 16V X7R | C4, C8, C11 | Wurth Elektronik | 885012206034 | 603
4 | 1 | 470u 63V | C14 | Nichicon | UPW1J471MHD3
5 | 3 | 4u7 50V X7R | C17, C21, C25 | Taiyo Yuden | UMK316AB7475KL-T | 1206
6 | 1 | 10u 25V X5R/X7R | C20 | Taiyo Yuden | TMK325BJ106MN-T | 1210
7 | 2 | 22u 10V X5R/X7R | C28 | Samsung | CL32A226KPJNNNE | 1210
8 | 2 | 33u 10V X5R/X7R | C24 | TDK | C3225X5R1A336M200AC | 1210
9 | 0 |  | C2, C5, C6, C10
10 | 4 | 47k | R1, R27, R28, R29 | Yageo | RC0603FR-0747KL | 603
11 | 1 | 120R | R2 | Bourns | CR0805-FX-120ELF | 805
12 | 1 | 470R | R3 | Bourns | CR0805-FX-4700ELF | 805
13 | 3 | 0R | R4, R6, R12 | Vishay | CRCW06030000Z0EBC | 603
14 | 2 | 4k7 | R5, R16 | Yageo | RC0603FR-074K7L | 603
15 | 2 | 68k 0,5% | R10, R17 | Panasonic | ERJ-3RBD6802V | 603
16 | 2 | 12k 0,5% | R11, R18 | Panasonic | ERJ-3RBD123V | 603
17 | 1 | 240k 0,1% | R19 | Vishay | TNPW0603240KBEEA | 603
18 | 4 | 10k | R20, R21, R22, R31 | Yageo | RC0603FR-0710KL | 603
19 | 3 | 100R | R23, R24, R25 | Yageo | RC0603FR-07100RL | 603
20 | 1 | 88k7 / 1% | R34 | Panasonic | ERJ-3EKF8872V | 603
21 | 1 | 6k04 / 1% | R35 | Panasonic | ERJ-3EKF6041V | 603
22 | 3 | 1k | R36, R39, R42 | Bourns | CR0805-FX-1001ELF | 805
23 | 1 | 28k / 1% | R37 | Panasonic | ERJ-3EKF2802V | 603
24 | 1 | 8k45 / 1% | R38 | Panasonic | ERJ-3EKF8451V | 603
25 | 1 | 57k6 / 1% | R40 | Panasonic | ERJ-3EKF5762V | 603
26 | 1 | 10k5 / 1% | R41 | Panasonic | ERJ-3EKF1052V | 603
27 | 0 |  | R7, R8, R9, R14, R26, R30
28 | 1 | 68u 520mA | L1 | Laird | TYS4030680M-10 | 4x4mm
29 | 1 | 33u 840mA | L2 | Laird | TYS4030330M-10 | 4x4mm
30 | 1 | 47u 720mA | L3 | Laird | TYS4030470M-10 | 4x4mm
31 | 1 | MSP430 Controller | U1 | TI | MSP430FR2355TDBT | TSSOP-38
32 | 1 | OpAmp | U3 | TI | LM358MX/NOPB | SOIC-8
33 | 3 | Buck Converter | U4, U5, U6 | TI | LMR16006XDDCR | SOT-23
34 | 1 | LED green | D1 | Wurth Elektronik | 150060VS75000 | 603
35 | 1 | LED red | D2 | Wurth Elektronik | 150060RS75000 | 603
36 | 4 | Series Schottky 40V 300mA | D3, D4, D7, D9 | ST | BAT54SFILMY | SOT-23
37 | 3 | Schottky 500mV 1A | D5, D8, D18 | Nexperia | PMEG2010EJ | SOD323F
38 | 0 | Zener 3,3V | D6, D10, D16, D17 |  | MM3Z3V3T1G | SOD323
39 | 0 | TVS 24V Uni | D11, D13, D14, D15 | Littelfuse | SMBJ24A | SMB J-Bend
40 | 4 | TVS 24V Uni | D11, D13, D14, D15 | Vishay | SMBJ24D-M3/H | SMB J-Bend
41 | 1 | Zener 10V 500mW | D12 | Diodes Inc | BZT52C10-7-F | SOD123
42 | 1 | Rectifier 400V/2A | D19 | Diodes Inc | MURS140-13-F | SMB J-Bend
43 | 3 | Logic N MOSFET 30V | Q1 - Q3 | Infineon | IRLR8743TRPBF | D-Pak
44 | 1 | P MOSFET | Q5 | ON Semi | ATP304-TL-H | ATPAK
45 | 1 | Button J | SW1 | C&K Switches | PTS645-S-K-50-JSMTR92-LFS
46 | 1 | 12pol 5mm 1,5² Connector | J2 | Phoenix Contact | 1792960 (PTS 1,5/12-5,0-H)
47 | 1 | 10pol 5mm 1,5² Connector | J4 | Phoenix Contact | 1792944 (PTS 1,5/10-5,0-H)
48 | 1 | 2pol 5mm 1,5² Connector | J3 | Phoenix Contact | 1792863 (PTS 1,5/ 2-5,0-H)
49 | 1 | BNC Horizontal | J5 | TE | 1-1337543-0
50 | 0 |  | J1, J6
51 | 1 | Pinsocket 2x7 2,54mm | DISP1 | 3M | 929975-01-07-RK
