F-Wilke/TekadeCarPhone/BOM/20211104 BOM TeKaDe UIBoard.xlsx

Sheet: Tabelle1
 |  |  |  |  |  |  |  |  |  |  |  |  | Gesamtpreis
Item | Qty | Description | Reference | Mfr | Mfr P/N | Case | Qualification | Artikelnr | Distributor | Available | 10er Preis | 1000er Preis | 10er | 1000er
1 | 1 | 100n/16V/X5R | C1 | Taiyo Yuden | EMK107BJ104KAHT | 603 | AEC-Q200 | 963-EMK107BJ104KAHT | Mouser | 58000 | 0.03 € | 0.02 € | 0.03 € | 0.02 €
2 | 1 | 2u2/10V/X5R | C2 | Taiyo Yuden | LMK107BJ225KAHT | 603 | AEC-Q200 | 963-LMK107BJ225KAHT | Mouser | 20000 | 0.06 € | 0.02 € | 0.06 € | 0.02 €
3 | 1 | 220n/10V/X5R | C3 | Taiyo Yuden | EMK107BJ224KAHT | 603 | AEC-Q200 | 963-EMK107BJ224KAHT | Mouser | 4600 | 0.06 € | 0.02 € | 0.06 € | 0.02 €
4 | 1 | LDR 4,2x3,4mm 5M / 20k | R1 | Advanced Photonix | PDV-P9203 | THT 2,54mm | ~~RoHS~~ | PDV-P9203-ND | Digikey | 7400 | 1.32 € | 0.67 € | 1.32 € | 0.67 €
5 | 5 | 210R/5% | R2, R3, R4, R5, R6 | YAGEO | AC0603FR-07210RL | 603 | AEC-Q200 | 603-AC0603FR-07210RL | Mouser | 19000 | 0.03 € | 0.02 € | 0.12 € | 0.11 €
6 | 16 | 7 Segment Display RED CC | U1-U16 | Siemens | HD1077R | N/A | ~~RoHS~~ | HD1077R | Aeri | 8800 | on request
7 | 1 | Matrix Key Driver | U17 | Fairchild | MM74C923WM | SOIC-20 | ~~RoHS~~ | MM74C923WM | Aeri | 9000 | on request
8 | 18 | Switch Button | SW1-SW18 | C&K | KST221GLFS | 6x6mm Gullw. |  | 611-KST221GLFS | Mouser | 1000 | 0.67 € | 0.51 € | 12.11 € | 9.22 €
9 | 0 | Switch Button | SW1-SW18 | TE Connectivity | 1571634-2 | 6x6mm Gullw. |  | 506-1571634-2 | Mouser | 18500 | 0.41 € | 0.25 € | 0.00 € | 0.00 €
10 | 1 | LED RD TINTED DIFF 60° 635nm | D1 | Lumex | SSL-LX5093LID | T-1 3/4 (5mm) |  | 696-SSL-LX5093LID | Mouser | 4800 | 0.23 € | 0.09 € | 0.23 € | 0.09 €
11 | 1 | LED AMBER TINTED DIFF 60° 610nm | D2 | Lumex | SSL-LX5093AD | T-1 3/4 (5mm) |  | 696-SSL-LX5093AD | Mouser | 2100 | 0.25 € | 0.10 € | 0.25 € | 0.10 €
12 | 1 | LED GN TINTED DIFF 60° 565nm | D3 | Lumex | SSL-LX5093LGD-TR | T-1 3/4 (5mm) |  | 696-SSL-LX5093LGD-TR | Mouser | 9300 | 0.23 € | 0.12 € | 0.23 € | 0.12 €
13 | 1 | LED AMBER TINTED DIFF 60° 610nm | D4 | Lumex | SSL-LX3044AD | T-1 (3mm) |  | 696-SSL-LX3044AD | Mouser | 2400 | 0.26 € | 0.10 € | 0.26 € | 0.10 €
14 | 5 | LED WW DIFF | D5-D9 | QT Brightek (QTB) | QBL7IW60D-WW | T-1 (3mm) |  | 1516-QBL7IW60D-WW-ND | Digikey | 12400 | 0.35 € | 0.18 € | 1.75 € | 0.92 €
15 | 1 | Pinheader 2x08 P2,54 Vert | J1 | Amphenol FCI | 68602-116HLF | MateLen 5,84mm |  | 649-68602-116HLF | Mouser | 2700 | 0.71 € | 0.52 € | 0.71 € | 0.52 €
16 | 1 | Pinheader 2x15 P2,54 Vert | J2 | Amphenol FCI | 68602-130HLF | MateLen 5,84mm |  | 649-68602-130HLF | Mouser | 36 | 1.23 € | 1.05 € | 1.23 € | 1.05 €

Sheet: Tabelle2
Item | Qty | Description | Reference | Mfr | Mfr P/N | Case
1 | 6 | 100n 50V X7R | C1, C13, C19, C23, C27, C29 | Yageo | CC0603KRX7R9BB104 | 603
2 | 1 | 10u 6V3 X5R | C3 | KEMET | C0805C106K9PACTU | 805
3 | 3 | 1n 16V X7R | C4, C8, C11 | Wurth Elektronik | 885012206034 | 603
4 | 1 | 470u 63V | C14 | Nichicon | UPW1J471MHD3
5 | 3 | 4u7 50V X7R | C17, C21, C25 | Taiyo Yuden | UMK316AB7475KL-T | 1206
6 | 1 | 10u 25V X5R/X7R | C20 | Taiyo Yuden | TMK325BJ106MN-T | 1210
7 | 2 | 22u 10V X5R/X7R | C28 | Samsung | CL32A226KPJNNNE | 1210
8 | 2 | 33u 10V X5R/X7R | C24 | TDK | C3225X5R1A336M200AC | 1210
9 | 0 |  | C2, C5, C6, C10
10 | 4 | 47k | R1, R27, R28, R29 | Yageo | RC0603FR-0747KL | 603
11 | 1 | 120R | R2 | Bourns | CR0805-FX-120ELF | 805
12 | 1 | 470R | R3 | Bourns | CR0805-FX-4700ELF | 805
13 | 3 | 0R | R4, R6, R12 | Vishay | CRCW06030000Z0EBC | 603
14 | 2 | 4k7 | R5, R16 | Yageo | RC0603FR-074K7L | 603
15 | 2 | 68k 0,5% | R10, R17 | Panasonic | ERJ-3RBD6802V | 603
16 | 2 | 12k 0,5% | R11, R18 | Panasonic | ERJ-3RBD123V | 603
17 | 1 | 240k 0,1% | R19 | Vishay | TNPW0603240KBEEA | 603
18 | 4 | 10k | R20, R21, R22, R31 | Yageo | RC0603FR-0710KL | 603
19 | 3 | 100R | R23, R24, R25 | Yageo | RC0603FR-07100RL | 603
20 | 1 | 88k7 / 1% | R34 | Panasonic | ERJ-3EKF8872V | 603
21 | 1 | 6k04 / 1% | R35 | Panasonic | ERJ-3EKF6041V | 603
22 | 3 | 1k | R36, R39, R42 | Bourns | CR0805-FX-1001ELF | 805
23 | 1 | 28k / 1% | R37 | Panasonic | ERJ-3EKF2802V | 603
24 | 1 | 8k45 / 1% | R38 | Panasonic | ERJ-3EKF8451V | 603
25 | 1 | 57k6 / 1% | R40 | Panasonic | ERJ-3EKF5762V | 603
26 | 1 | 10k5 / 1% | R41 | Panasonic | ERJ-3EKF1052V | 603
27 | 0 |  | R7, R8, R9, R14, R26, R30
28 | 1 | 68u 520mA | L1 | Laird | TYS4030680M-10 | 4x4mm
29 | 1 | 33u 840mA | L2 | Laird | TYS4030330M-10 | 4x4mm
30 | 1 | 47u 720mA | L3 | Laird | TYS4030470M-10 | 4x4mm
31 | 1 | MSP430 Controller | U1 | TI | MSP430FR2355TDBT | TSSOP-38
32 | 1 | OpAmp | U3 | TI | LM358MX/NOPB | SOIC-8
33 | 3 | Buck Converter | U4, U5, U6 | TI | LMR16006XDDCR | SOT-23
34 | 1 | LED green | D1 | Wurth Elektronik | 150060VS75000 | 603
35 | 1 | LED red | D2 | Wurth Elektronik | 150060RS75000 | 603
36 | 4 | Series Schottky 40V 300mA | D3, D4, D7, D9 | ST | BAT54SFILMY | SOT-23
37 | 3 | Schottky 500mV 1A | D5, D8, D18 | Nexperia | PMEG2010EJ | SOD323F
38 | 0 | Zener 3,3V | D6, D10, D16, D17 |  | MM3Z3V3T1G | SOD323
39 | 0 | TVS 24V Uni | D11, D13, D14, D15 | Littelfuse | SMBJ24A | SMB J-Bend
40 | 4 | TVS 24V Uni | D11, D13, D14, D15 | Vishay | SMBJ24D-M3/H | SMB J-Bend
41 | 1 | Zener 10V 500mW | D12 | Diodes Inc | BZT52C10-7-F | SOD123
42 | 1 | Rectifier 400V/2A | D19 | Diodes Inc | MURS140-13-F | SMB J-Bend
43 | 3 | Logic N MOSFET 30V | Q1 - Q3 | Infineon | IRLR8743TRPBF | D-Pak
44 | 1 | P MOSFET | Q5 | ON Semi | ATP304-TL-H | ATPAK
45 | 1 | Button J | SW1 | C&K Switches | PTS645-S-K-50-JSMTR92-LFS
46 | 1 | 12pol 5mm 1,5² Connector | J2 | Phoenix Contact | 1792960 (PTS 1,5/12-5,0-H)
47 | 1 | 10pol 5mm 1,5² Connector | J4 | Phoenix Contact | 1792944 (PTS 1,5/10-5,0-H)
48 | 1 | 2pol 5mm 1,5² Connector | J3 | Phoenix Contact | 1792863 (PTS 1,5/ 2-5,0-H)
49 | 1 | BNC Horizontal | J5 | TE | 1-1337543-0
50 | 0 |  | J1, J6
51 | 1 | Pinsocket 2x7 2,54mm | DISP1 | 3M | 929975-01-07-RK
