F-Wilke/TekadeCarPhone/UIBoardStandalone.kicad_pcb

## KiCad design UIBoardStandalone.kicad_pcb (2021-11-02)

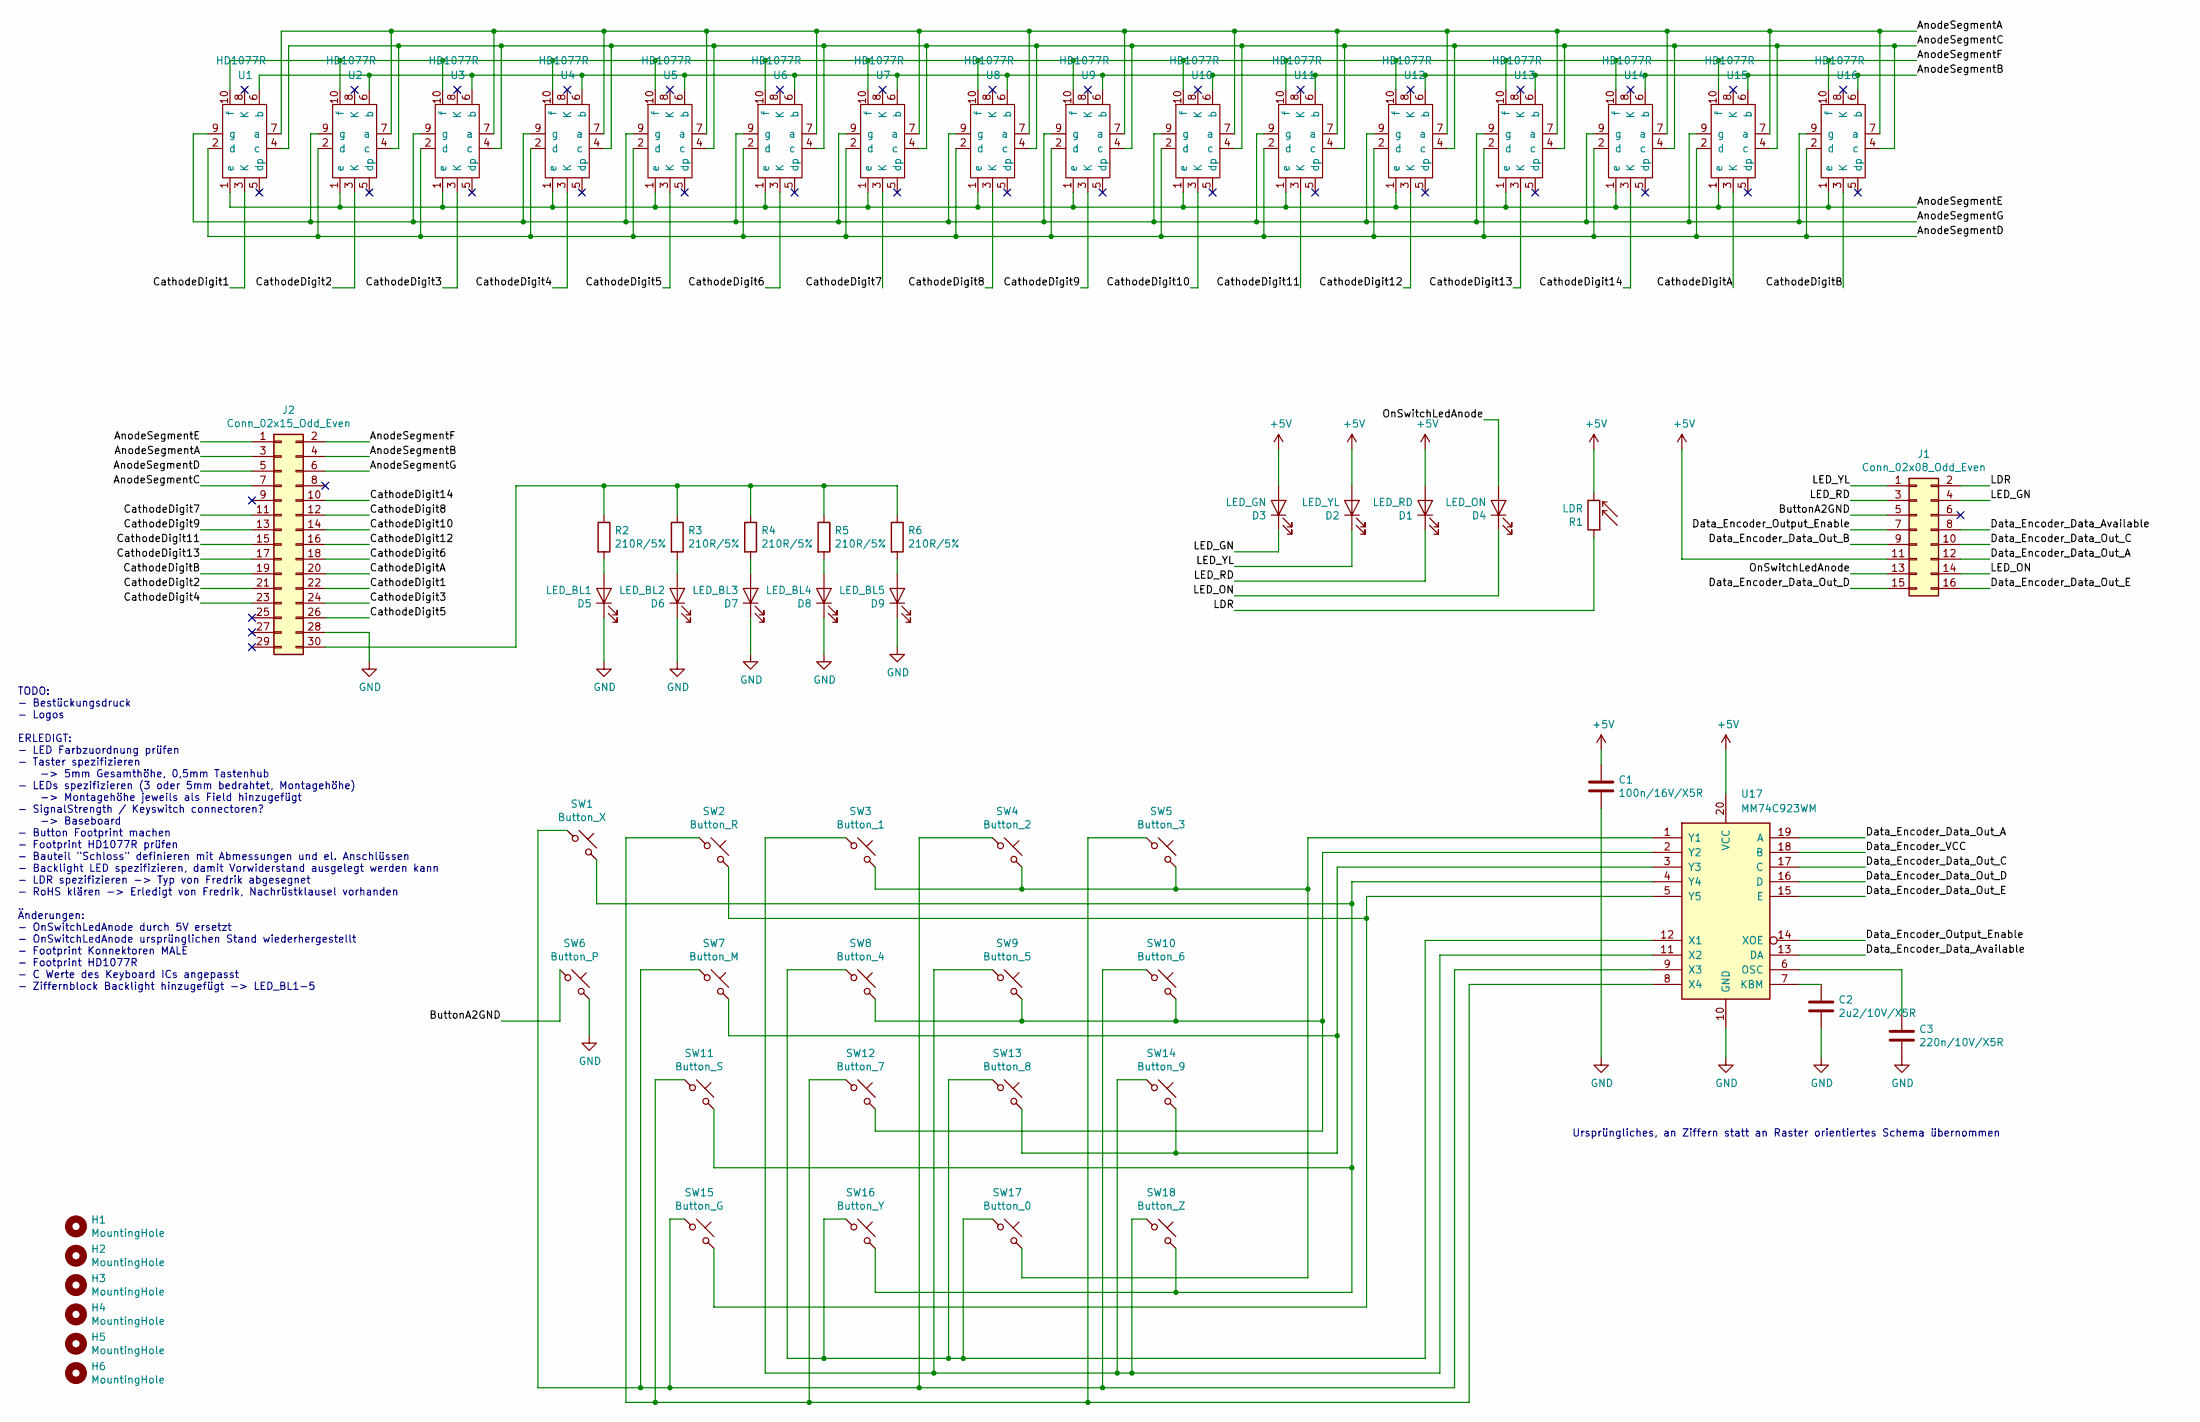
[picture p9: schematic UIBoardStandalone.sch]

Parts:
C1: 100n/16V/X5R; C_0603_1608Metric
C2: 2u2/10V/X5R; C_0603_1608Metric
C3: 220n/10V/X5R; C_0603_1608Metric
D1: LED_RD; LED_D5.0mm
D2: LED_YL; LED_D5.0mm
D3: LED_GN; LED_D5.0mm
D4: LED_ON; LED_D3.0mm
D5: LED_BL1; LED_D3.0mm
D6: LED_BL2; LED_D3.0mm
D7: LED_BL3; LED_D3.0mm
D8: LED_BL4; LED_D3.0mm
D9: LED_BL5; LED_D3.0mm
H1, H2, H3, H4, H5, H6: MountingHole; MountingHole_3.2mm_M3_DIN965
J1: Conn_02x08_Odd_Even; PinHeader_2x08_P2.54mm_Vertical
J2: Conn_02x15_Odd_Even; PinHeader_2x15_P2.54mm_Vertical
R1: LDR; R_LDR_4.9x4.2mm_P2.54mm_Vertical
R2, R3, R4, R5, R6: 210R/5%; R_0603_1608Metric
SW1: Button_X; SW_Push_CK_KST2x1G
SW2: Button_R; SW_Push_CK_KST2x1G
SW3: Button_1; SW_Push_CK_KST2x1G
SW4: Button_2; SW_Push_CK_KST2x1G
SW5: Button_3; SW_Push_CK_KST2x1G
SW6: Button_P; SW_Push_CK_KST2x1G
SW7: Button_M; SW_Push_CK_KST2x1G
SW8: Button_4; SW_Push_CK_KST2x1G
SW9: Button_5; SW_Push_CK_KST2x1G
SW10: Button_6; SW_Push_CK_KST2x1G
SW11: Button_S; SW_Push_CK_KST2x1G
SW12: Button_7; SW_Push_CK_KST2x1G
SW13: Button_8; SW_Push_CK_KST2x1G
SW14: Button_9; SW_Push_CK_KST2x1G
SW15: Button_G; SW_Push_CK_KST2x1G
SW16: Button_Y; SW_Push_CK_KST2x1G
SW17: Button_0; SW_Push_CK_KST2x1G
SW18: Button_Z; SW_Push_CK_KST2x1G
U1, U2, U3, U4, U5, U6, U7, U8, U9, U10, U11, U12, U13, U14, U15, U16: HD1077R; 7SegmentLED_HD1077R
U17: MM74C923WM; SOIC-20W_7.5x12.8mm_P1.27mm

Connections:
+5V: C1.1, D1.2 (A), D2.2 (A), D3.2 (A), J1.11, R1.2, U17.20 (VCC)
/AnodeSegmentA: J2.3, U1.7 (a), U2.7 (a), U3.7 (a), U4.7 (a), U5.7 (a), U6.7 (a), U7.7 (a), U8.7 (a), U9.7 (a), U10.7 (a), U11.7 (a), U12.7 (a), U13.7 (a), U14.7 (a), U15.7 (a), U16.7 (a)
/AnodeSegmentB: J2.4, U1.6 (b), U2.6 (b), U3.6 (b), U4.6 (b), U5.6 (b), U6.6 (b), U7.6 (b), U8.6 (b), U9.6 (b), U10.6 (b), U11.6 (b), U12.6 (b), U13.6 (b), U14.6 (b), U15.6 (b), U16.6 (b)
/AnodeSegmentC: J2.7, U1.4 (c), U2.4 (c), U3.4 (c), U4.4 (c), U5.4 (c), U6.4 (c), U7.4 (c), U8.4 (c), U9.4 (c), U10.4 (c), U11.4 (c), U12.4 (c), U13.4 (c), U14.4 (c), U15.4 (c), U16.4 (c)
/AnodeSegmentD: J2.5, U1.2 (d), U2.2 (d), U3.2 (d), U4.2 (d), U5.2 (d), U6.2 (d), U7.2 (d), U8.2 (d), U9.2 (d), U10.2 (d), U11.2 (d), U12.2 (d), U13.2 (d), U14.2 (d), U15.2 (d), U16.2 (d)
/AnodeSegmentE: J2.1, U1.1 (e), U2.1 (e), U3.1 (e), U4.1 (e), U5.1 (e), U6.1 (e), U7.1 (e), U8.1 (e), U9.1 (e), U10.1 (e), U11.1 (e), U12.1 (e), U13.1 (e), U14.1 (e), U15.1 (e), U16.1 (e)
/AnodeSegmentF: J2.2, U1.10 (f), U2.10 (f), U3.10 (f), U4.10 (f), U5.10 (f), U6.10 (f), U7.10 (f), U8.10 (f), U9.10 (f), U10.10 (f), U11.10 (f), U12.10 (f), U13.10 (f), U14.10 (f), U15.10 (f), U16.10 (f)
/AnodeSegmentG: J2.6, U1.9 (g), U2.9 (g), U3.9 (g), U4.9 (g), U5.9 (g), U6.9 (g), U7.9 (g), U8.9 (g), U9.9 (g), U10.9 (g), U11.9 (g), U12.9 (g), U13.9 (g), U14.9 (g), U15.9 (g), U16.9 (g)
/ButtonA2GND: J1.5, SW6.1
/CathodeDigit1: J2.22, U1.3 (K)
/CathodeDigit2: J2.21, U2.3 (K)
/CathodeDigit3: J2.24, U3.3 (K)
/CathodeDigit4: J2.23, U4.3 (K)
/CathodeDigit5: J2.26, U5.3 (K)
/CathodeDigit6: J2.18, U6.3 (K)
/CathodeDigit7: J2.11, U7.3 (K)
/CathodeDigit8: J2.12, U8.3 (K)
/CathodeDigit9: J2.13, U9.3 (K)
/CathodeDigit10: J2.14, U10.3 (K)
/CathodeDigit11: J2.15, U11.3 (K)
/CathodeDigit12: J2.16, U12.3 (K)
/CathodeDigit13: J2.17, U13.3 (K)
/CathodeDigit14: J2.10, U14.3 (K)
/CathodeDigitA: J2.20, U15.3 (K)
/CathodeDigitB: J2.19, U16.3 (K)
/Data_Encoder_Data_Available: J1.8, U17.13 (DA)
/Data_Encoder_Data_Out_A: J1.12, U17.19 (A)
/Data_Encoder_Data_Out_B: J1.9
/Data_Encoder_Data_Out_C: J1.10, U17.17 (C)
/Data_Encoder_Data_Out_D: J1.15, U17.16 (D)
/Data_Encoder_Data_Out_E: J1.16, U17.15 (E)
/Data_Encoder_Output_Enable: J1.7, U17.14 (XOE)
/Data_Encoder_VCC: U17.18 (B)
/LDR: J1.2, R1.1
/LED_GN: D3.1 (K), J1.4
/LED_ON: D4.1 (K), J1.14
/LED_RD: D1.1 (K), J1.3
/LED_YL: D2.1 (K), J1.1
/OnSwitchLedAnode: D4.2 (A), J1.13
GND: C1.2, C2.2, C3.2, D5.1 (K), D6.1 (K), D7.1 (K), D8.1 (K), D9.1 (K), J2.28, SW6.2, U17.10 (GND)
unnamed: C2.1, U17.7 (KBM)
unnamed: C3.1, U17.6 (OSC)
unnamed: D5.2 (A), R2.2
unnamed: D6.2 (A), R3.2
unnamed: D7.2 (A), R4.2
unnamed: D8.2 (A), R5.2
unnamed: D9.2 (A), R6.2
unnamed: J2.30, R2.1, R3.1, R4.1, R5.1, R6.1
unnamed: SW1.1, SW4.1, SW7.1, SW10.1, SW15.1, U17.9 (X3)
unnamed: SW1.2, SW11.2, SW16.2, SW18.2, U17.4 (Y4)
unnamed: SW8.2, SW9.2, SW10.2, SW12.2, U17.2 (Y2)
unnamed: SW2.1, SW5.1, SW11.1, SW12.1, U17.8 (X4)
unnamed: SW8.1, SW13.1, SW16.1, SW17.1, U17.12 (X1)
unnamed: SW7.2, SW13.2, SW14.2, U17.3 (Y3)
unnamed: SW3.1, SW9.1, SW14.1, SW18.1, U17.11 (X2)
unnamed: SW2.2, SW15.2, U17.5 (Y5)
unnamed: SW3.2, SW4.2, SW5.2, SW17.2, U17.1 (Y1)

Notes on the sheet:
Ursprüngliches, an Ziffern statt an Raster orientiertes Schema übernommen
TODO: - Bestückungsdruck - Logos ERLEDIGT: - LED Farbzuordnung prüfen - Taster spezifizieren -> 5mm Gesamthöhe, 0,5mm Tastenhub - LEDs spezifizieren (3 oder 5mm bedrahtet, Montagehöhe) -> Montagehöhe jeweils als Field hinzugefügt - SignalStrength / Keyswitch connectoren? -> Baseboard - Button Footp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

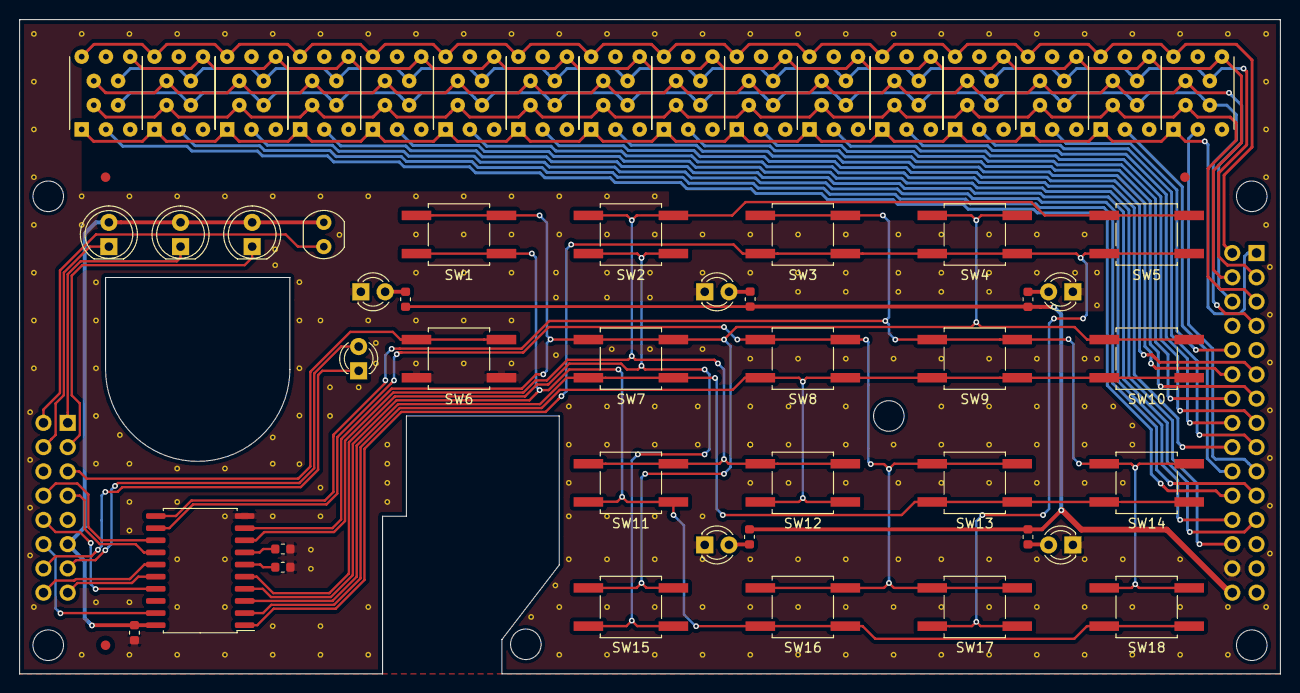
[picture p10: board UIBoardStandalone.kicad_pcb from above]

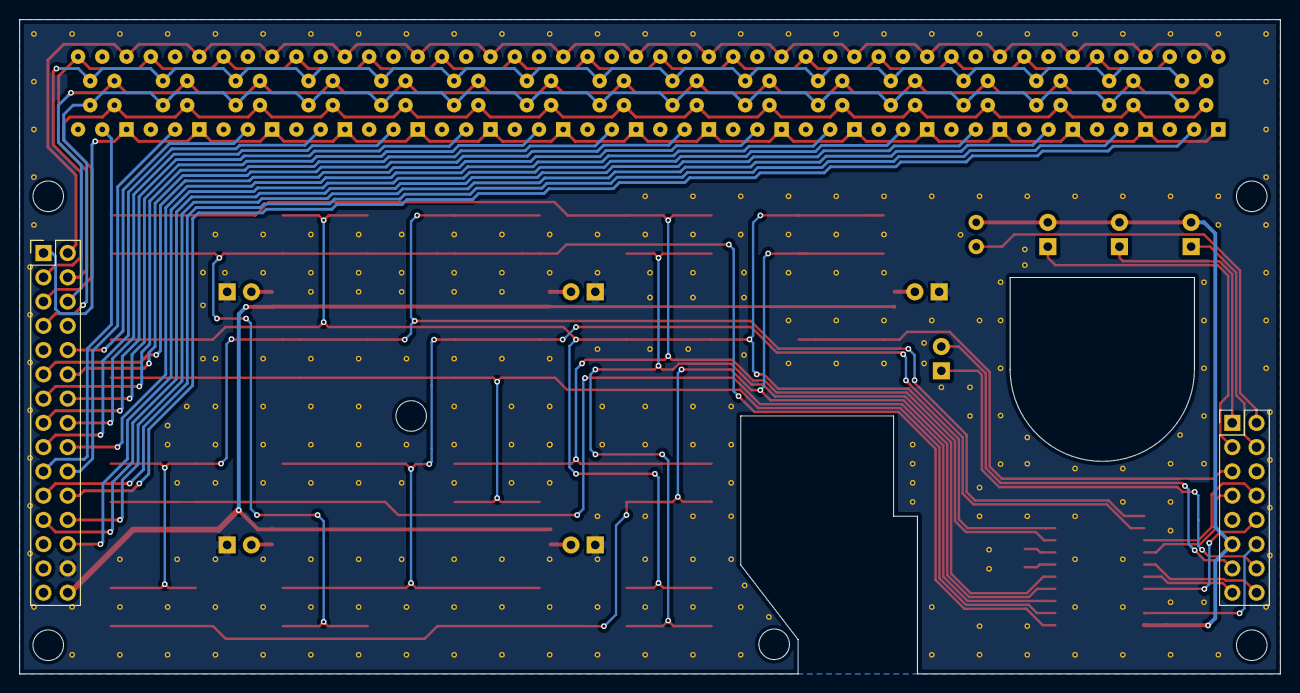
[picture p11: board UIBoardStandalone.kicad_pcb from below]

Board: 2 copper layers, 132.0 x 68.5 mm, 61 parts (2 on the bottom side), 55 nets.
