F-Wilke/TekadeCarPhone/(commit log)

2021-06-10 Name changes: RN52 -> BM83 removal of legacy USB Labels
    [ReleaseDeviceDigitalAudio.sch]
2021-06-13 [modified:] Datasheet cleanup [modified:] lib cleanup [fix:] removed voltmeter from uiboard [fix:] mic audio jack terminal mix-up
    [ABMM-6.000MHZ-B2-T.step, ANALOGDEVICESSIMULATION.DSN, AnalogDevicesSimulation.opj, MOUDLE-BLUETOOTH-AUDIO-RN52-I_RM_50P-26X13.5MM_.step, ReleaseDeviceDigitalAudio.sch, UIBoardStandalone.sch]
2021-06-15 -Symbole angepasst -Audio Mixing umgezeichnet -Audio Mixing teilweise geprüft
    [AudioMixing.sch, ReleaseDeviceDigitalAudio.sch, TIDA-00746-SchDoc.sch]
2021-06-16 Alle Libs zusammengefasst in TeKaDe.lib Power Supply mit Standartbauteilen (nicht das Import Zeugs)
    [AudioMixing.sch, PowerSupply.sch, ReleaseDeviceDigitalAudio.sch, TIDA-00746-SchDoc.sch, UIBoardStandalone.sch, core-2020-05-30-18-43-34.sch, core-2020-05-30-18-44-14.sch]
2021-06-16 - Alles aus rescue Lib noch in neue Lib gepackt
    [AudioMixing.sch, PowerSupply.sch, ReleaseDeviceDigitalAudio.sch]
2021-06-17 Footprint Libs wieder hinzugefügt Bugfix: 5VD Netz in 5V geändert
    [ReleaseDeviceDigitalAudio.sch]
2021-06-22 Footprints überarbeitet MAX98089 mit 3V3 Speaker Versorgung machen, damit hier nicht 5V geroutet werden müssen
    [AudioMixing.sch]
2021-06-22 hierarchical layout: RPi, Bluetooth module bus implementation Switch to RPi MiniUart
    [AudioMixing.sch, BluetoothModule.sch, PowerSupply.sch, RaspberryPiCM.sch, ReleaseDeviceDigitalAudio.sch]
2021-06-24 PowerSupply update
    [AudioMixing.sch, BluetoothModule.sch, PowerSupply.sch, RaspberryPiCM.sch, ReleaseDeviceDigitalAudio.sch]
2021-06-24 Mehr Hierarchie
    [7SegmentDriver.sch, AudioMixing.sch, BluetoothModule.sch, ControllerUIBoard.sch, PowerSupply.sch, RaspberryPiCM.sch, ReleaseDeviceDigitalAudio.sch]
2021-06-25 [modified:] RTC revision [add:] RPis second I2C port
    [RaspberryPiCM.sch, ReleaseDeviceDigitalAudio.sch]
2021-06-25 [add:] MAX98089 Line Out caps
    [AudioMixing.sch]
2021-06-25 [modified:] RPI I2C splitting
    [AudioMixing.sch, ReleaseDeviceDigitalAudio.sch]
2021-06-25 BN83 Zwischenstand
    [AudioMixing.sch, BluetoothModule.sch]
2021-06-26 [added:] 5V buck converter enable circuit [added:] RPi power up circuit
    [ControllerUIBoard.sch, PowerSupply.sch, RaspberryPiCM.sch, ReleaseDeviceDigitalAudio.sch]
2021-06-27 [add:] second RPi uart [add:] ATMEGA RPi UART communication incl. level shifting
    [BluetoothModule.sch, ControllerUIBoard.sch, RaspberryPiCM.sch, ReleaseDeviceDigitalAudio.sch]
2021-06-27 [modified:] Display driving cleanup
    [7SegmentDriver.sch, ReleaseDeviceDigitalAudio.sch]
2021-06-27 [fix:] differential microphone input
    [AudioMixing.sch]
2021-06-27 [fix:] corrected CD4515 to CD4514
    [7SegmentDriver.sch]
2021-06-28 - Busbenennungen angepasst - Kommentare angefügt
    [AudioMixing.sch, BluetoothModule.sch, RaspberryPiCM.sch, ReleaseDeviceDigitalAudio.sch]
2021-06-28 [modified:] merge precautions
    [ReleaseDeviceDigitalAudio.sch]
2021-06-29 [fix:] merge cleanup
    [RaspberryPiCM.sch, ReleaseDeviceDigitalAudio.sch]
2021-06-29 [modified:] Digit nomenclature clarification
    [ReleaseDeviceDigitalAudio.sch, UIBoardStandalone.sch]
2021-07-07 - MAX98089 fertig - Footprints von MAX und Oszilator angepasst - Pullups für I2C hinzugefügt - Bus / Signal Namen Fehlzuweisungen ausgebessert
    [AudioMixing.sch, BluetoothModule.sch, ControllerUIBoard.sch, RaspberryPiCM.sch, ReleaseDeviceDigitalAudio.sch]
2021-07-07 - Earth durch GND an den letzten Stellen ersetzt
    [BluetoothModule.sch, ControllerUIBoard.sch, ReleaseDeviceDigitalAudio.sch]
2021-07-09 - BT fertig, warten auf Rueckmeldung von Microchip - CM3 fast fertig - diverse Kleinigkeiten
    [7SegmentDriver.sch, AudioMixing.sch, BluetoothModule.sch, ControllerUIBoard.sch, PowerSupply.sch, RaspberryPiCM.sch, ReleaseDeviceDigitalAudio.sch]
2021-07-10 - CM3 durch CM4 ersetzt - Spannungsregler für 3,3 und 1,8V entfernt, da nun von CM4 erzeugt - RTC IC getauscht
    [7SegmentDriver.sch, AudioMixing.sch, BluetoothModule.sch, ControllerUIBoard.sch, PowerSupplyCM4.sch, RTC.sch, RaspberryPiCM3.sch, RaspberryPiCM4.sch]
2021-07-10 - Files aufgeraeumt
    [PowerSupplyCM3.sch, RaspberryPiCM.sch]
2021-07-10 - 0R Bruecken hinzugefuegt - viele Detailinfos
    [RaspberryPiCM4.sch]
2021-07-11 - Bus Topologie entfernt - Levelshifter auf eigenes Blatt, abgeschlossen
    [7SegmentDriver.sch, AudioMixing.sch, BluetoothModule.sch, ControllerUIBoard.sch, LevelShift.sch, PowerSupplyCM4.sch, RTC.sch, RaspberryPiCM4.sch]
2021-07-11 [added:] ATMEGA 4809 integration
    [ControllerUIBoard.sch]
2021-07-11 - Zwischenstand Display Driving
    [7SegmentDriver.sch, AudioMixing.sch, BluetoothModule.sch, ControllerUIBoard.sch, ReleaseDeviceDigitalAudio.sch]
2021-07-11 [modified:] uln2003 package swap [modified:] Display nomenclature update
    [7SegmentDriver.sch, ControllerUIBoard.sch, LevelShift.sch, UIBoardStandalone.sch]
2021-07-11 - Display Driving abgeschlossen
    [7SegmentDriver.sch, BluetoothModule.sch, ControllerUIBoard.sch]
2021-07-12 - CM4 update - Todo Liste auf Hauptschaltplan hinzugefügt
    [AudioMixing.sch, BluetoothModule.sch, PowerSupplyCM4.sch, RaspberryPiCM4.sch, ReleaseDeviceDigitalAudio.sch]
2021-07-13 - Selbsthalteschaltung vorerst fertig, Simulation folgt
    [PowerSupplyCM4.sch, ReleaseDeviceDigitalAudio.sch]
2021-07-14 - Kleinigkeiten
    [PowerSupplyCM4.sch]
2021-07-14 - ESD Schutz Zündung
    [PowerSupplyCM4.sch, ReleaseDeviceDigitalAudio.sch]
2021-07-15 - ATmega überarbeitet - Alle offenen Punkte zusammengefasst
    [7SegmentDriver.sch, AudioMixing.sch, BluetoothModule.sch, ControllerUIBoard.sch, LevelShift.sch, PowerSupplyCM4.sch, RTC.sch, RaspberryPiCM4.sch]
2021-07-15 - Platzoptimierungen
    [7SegmentDriver.sch, AudioMixing.sch, BluetoothModule.sch, ControllerUIBoard.sch, LevelShift.sch, PowerSupplyCM4.sch, RTC.sch, RaspberryPiCM4.sch]
2021-08-04 [fix:] general troublespots -> notes
    [ControllerUIBoard.sch, LevelShift.sch, RaspberryPiCM4.sch, ReleaseDeviceDigitalAudio.sch, UIBoardStandalone.sch]
2021-08-07 - Kommentare aktualisiert
    [7SegmentDriver.sch, AudioMixing.sch, BluetoothModule.sch, ReleaseDeviceDigitalAudio.sch, UIBoardStandalone.sch]
2021-08-13 - Footprint HD1077R
    [UIBoardStandalone.kicad_pcb, UIBoardStandalone.sch]
2021-08-16 - Outline und erste Plazierungen
    [UIBoardStandalone.sch]
2021-08-16 - Steckverbinder auf Rueckseite gespiegelt
    [UIBoardStandalone.kicad_pcb]
2021-08-19 - Outline / Postionierung Zwischenstand
    [ReleaseDeviceDigitalAudio.kicad_pcb, ReleaseDeviceDigitalAudio.sch, UIBoardStandalone.kicad_pcb, UIBoardStandalone.sch]
2021-08-19 - erster Stand für Abmessungen
    [ReleaseDeviceDigitalAudio.kicad_pcb, ReleaseDeviceDigitalAudio.sch, UIBoardStandalone.kicad_pcb, UIBoardStandalone.sch]
2021-08-23 [fix:] measurement errors [add:] backlight LEDs
    [UIBoardStandalone.kicad_pcb, UIBoardStandalone.sch]
2021-09-17 [mod:] updated keyboard controller caps, notes
    [UIBoardStandalone.sch]
2021-09-18 [mod:] BM83 issues resolved: MCLK, unused pins
    [BluetoothModule.sch, ReleaseDeviceDigitalAudio.sch]
2021-09-19 [mod:] Atmega issues resolved: Programming interface, self cutoff
    [PowerSupplyCM4.sch, ReleaseDeviceDigitalAudio.sch]
2021-09-20 [mod:] BM83.MFB connection removed
    [BluetoothModule.sch, RaspberryPiCM4.sch, ReleaseDeviceDigitalAudio.sch]
2021-09-20 [mod:] UIBoard buttons specified
    [UIBoardStandalone.sch]
2021-09-22 - Anpassungen ToDos und kleinere Änderungen
    [BluetoothModule.sch, PowerSupplyCM4.sch, ReleaseDeviceDigitalAudio.sch, UIBoardStandalone.sch]
2021-09-25 [mod:] Note updates, KeySwitch mechanical definition
    [7SegmentDriver.sch, AudioMixing.sch, BluetoothModule.sch, ControllerUIBoard.sch, LevelShift.sch, PowerSupplyCM4.sch, RTC.sch, RaspberryPiCM4.sch]
2021-09-25 [mod:] note updates
    [UIBoardStandalone.sch]
2021-10-12 - Erster Stand UI Board Layout
    [7SegmentDriver.sch, AudioMixing.sch, BluetoothModule.sch, ControllerUIBoard.sch, LevelShift.sch, PowerSupplyCM4.sch, RTC.sch, RaspberryPiCM4.sch]
2021-10-12 - Libs hinzugefügt / merge fertig
    [ReleaseDeviceDigitalAudio.kicad_pcb, ReleaseDeviceDigitalAudio.sch]
2021-10-17 [add:] LED specifications
    [UIBoardStandalone.sch]
2021-10-17 [mod:] MCLK input to MAX98089 from BM83 at 12.28MHz
    [7SegmentDriver.sch, AudioMixing.sch, BluetoothModule.sch, ControllerUIBoard.sch, LevelShift.sch, PowerSupplyCM4.sch, RTC.sch, RaspberryPiCM4.sch]
2021-10-18 [add:] explanations omitted in last commit
    [AudioMixing.sch, ReleaseDeviceDigitalAudio.sch]
2021-10-27 [fix:] LED definition bug
    [UIBoardStandalone.kicad_pcb, UIBoardStandalone.sch]
2021-10-27 - R Values hinzugefügt - Text aktualisiert - vorläufe BOM hinzugefügt
    [20211027 BOM UIBoard.xlsx, UIBoardStandalone.kicad_pcb, UIBoardStandalone.sch]
2021-10-29 - UI Backlight schaltbar gemacht, erster Entwurf, +5VA Symbol durch Label ersetzt
    [7SegmentDriver.sch, AudioMixing.sch, BluetoothModule.sch, ControllerUIBoard.sch, LevelShift.sch, PowerSupplyCM4.sch, RTC.sch, RaspberryPiCM4.sch]
2021-10-31 [mod:] socket pin mirroring
    [7SegmentDriver.sch, AudioMixing.sch, BluetoothModule.sch, ControllerUIBoard.sch, LevelShift.sch, PowerSupplyCM4.sch, RTC.sch, RaspberryPiCM4.sch]
2021-11-01 - Signalnamen korrigiert, Spiegelung geprüft
    [7SegmentDriver.sch, AudioMixing.sch, BluetoothModule.sch, ControllerUIBoard.sch, LevelShift.sch, PowerSupplyCM4.sch, RTC.sch, RaspberryPiCM4.sch]
2021-11-01 - Schaltbare BL Versorgung fertig - kleinere Value Anpassungen - Finale Annotation
    [7SegmentDriver.sch, AudioMixing.sch, BluetoothModule.sch, ControllerUIBoard.sch, LevelShift.sch, PowerSupplyCM4.sch, RTC.sch, RaspberryPiCM4.sch]
2021-11-02 - Bauteile konsolidiert
    [AudioMixing.sch, BluetoothModule.sch, ControllerUIBoard.sch, PowerSupplyCM4.sch, ReleaseDeviceDigitalAudio.kicad_pcb]
2021-11-02 - BOM updates
    [20211102 BOM TeKaDe Baseboard.xlsx, 20211102 BOM TeKaDe UIBoard.xlsx]
2021-11-02 - fix: footprint getauscht
    [7SegmentDriver.sch, ReleaseDeviceDigitalAudio.kicad_pcb]
2021-11-02 - SW1 entfernt
    [20211102 BOM TeKaDe Baseboard.xlsx, ControllerUIBoard.sch, ReleaseDeviceDigitalAudio.kicad_pcb, ReleaseDeviceDigitalAudio.sch, UIBoardStandalone.sch]
2021-11-02 - Wert und Footprint der LED Vorwiderstaende angepasst
    [20211102 BOM TeKaDe Baseboard.xlsx, 20211102 BOM TeKaDe UIBoard.xlsx, ControllerUIBoard.sch, ReleaseDeviceDigitalAudio.kicad_pcb, ReleaseDeviceDigitalAudio.sch, UIBoardStandalone.kicad_pcb, UIBoardStandalone.sch]
2021-11-02 - Steckverbinder Signal und Lock aktualisiert
    [20211102 BOM TeKaDe Baseboard.xlsx, ControllerUIBoard.sch, ReleaseDeviceDigitalAudio.kicad_pcb]
2021-11-04 - BOMs aktualisiert
    [20211104 BOM TeKaDe Baseboard.xlsx, 20211104 BOM TeKaDe UIBoard.xlsx]
2021-11-04 - minimale Datenblatt und BOM Korrekturen
    [20211104 BOM TeKaDe Baseboard.xlsx]
2021-11-04 - vorlaeufige Bauteil Positionierung
    [ControllerUIBoard.sch, ReleaseDeviceDigitalAudio.kicad_pcb]
2021-11-10 BOM update
    [20211110 BOM TeKaDe Baseboard.xlsx]
2021-11-11 - Board auf 4 Lagen umgestellt, GND und 5V Lagen eingefügt
    [ReleaseDeviceDigitalAudio.kicad_pcb]
2021-11-11 - neue Stecker hinzugefügt, Annotation überall entsprechend angepasst Footprint fehlt noch
    [20211111 BOM TeKaDe Baseboard.xlsx, 7SegmentDriver.sch, ControllerUIBoard.sch, PowerSupplyCM4.sch, ReleaseDeviceDigitalAudio.kicad_pcb, ReleaseDeviceDigitalAudio.sch]
2021-11-11 - Footprints inkl. 3D model aller Steckverbinder fertig
    [ControllerUIBoard.sch, PowerSupplyCM4.sch, ReleaseDeviceDigitalAudio.kicad_pcb, ReleaseDeviceDigitalAudio.sch]
2021-11-11 - Ausschnitt für BT Antenne und weitere Optimierungen
    [ReleaseDeviceDigitalAudio.kicad_pcb]
2021-11-28 - auf 20pol Audiostecker umgebaut
    [20211128 BOM TeKaDe Baseboard.xlsx, ReleaseDeviceDigitalAudio.kicad_pcb, ReleaseDeviceDigitalAudio.sch]
2021-12-01 - Layout Zwischenstand, UI Board Ansteuerung fast fertig - GPIOs von ATmega komplett umsortiert - Darlington Anschlüsse umsortiert
    [7SegmentDriver.sch, ControllerUIBoard.sch, RTC.sch, ReleaseDeviceDigitalAudio.kicad_pcb, ReleaseDeviceDigitalAudio.sch]
2021-12-28 - BT1 fixed
    [20211210 BOM TeKaDe Baseboard.xlsx, RTC.sch, ReleaseDeviceDigitalAudio.kicad_pcb]
2022-01-07 - Layout MAX98 - Audiostecker Belegung angepasst
    [AudioMixing.sch, BluetoothModule.sch, ReleaseDeviceDigitalAudio.kicad_pcb, ReleaseDeviceDigitalAudio.sch]
2022-01-08 - IRQ Pullup Spannung auf 3,3V
    [AudioMixing.sch, ReleaseDeviceDigitalAudio.kicad_pcb]
2022-01-12 - Letzter Zwischenstand vor Branch. Alles außer Spannungsversorgung und Zündung ist vorerst fertig.
    [BluetoothModule.sch, ControllerUIBoard.sch, ReleaseDeviceDigitalAudio.kicad_pcb]
2022-01-14 - Zwischenstand
    [20220114 BOM TeKaDe Baseboard 5VEXT.xlsx, PowerSupplyCM4.sch, ReleaseDeviceDigitalAudio.kicad_pcb]
2022-01-16 - Galvanische Trennung zu KFZ abgeschlossen
    [20220116 BOM TeKaDe Baseboard 5VEXT.xlsx, ControllerUIBoard.sch, PowerSupplyCM4.sch, ReleaseDeviceDigitalAudio.kicad_pcb, ReleaseDeviceDigitalAudio.sch]
2022-01-16 - Merged Fix for ACM1211 footprint
    [ReleaseDeviceDigitalAudio.kicad_pcb]
2022-01-16 - Fiducials und Logos hinzugefügt
    [ReleaseDeviceDigitalAudio.kicad_pcb]
2022-01-17 - Fix: alle DRC Fehler bereinigt
    [ReleaseDeviceDigitalAudio.kicad_pcb]
2022-01-17 - Fix: Merged DRC fixes from 5VEXT branch
    [ReleaseDeviceDigitalAudio.kicad_pcb]
2022-01-17 - Eigene Masse Insel für Audio - Footprint Terminal PT durch PTS ersetzt (baut nur etwas tiefer)
    [AudioMixing.sch, PowerSupplyCM4.sch, ReleaseDeviceDigitalAudio.kicad_pcb, ReleaseDeviceDigitalAudio.sch]
2022-01-17 - Fix: Darlington Pad NICHT elektrisch verbinden!
    [7SegmentDriver.sch, ReleaseDeviceDigitalAudio.kicad_pcb]
2022-01-17 - merged Fix pad not on gnd
    [7SegmentDriver.sch, ReleaseDeviceDigitalAudio.kicad_pcb]
2022-01-17 - Pasten und Masken von Darlingtons und MAX angepasst
    [7SegmentDriver.sch, ReleaseDeviceDigitalAudio.kicad_pcb]
2022-01-17 - merged fix: max and darlington pads and paste
    [ReleaseDeviceDigitalAudio.kicad_pcb]
2022-01-18 - BOM und Feinheiten
    [20220118 BOM TeKaDe Baseboard 5VEXT.xlsx, PowerSupplyCM4.sch, ReleaseDeviceDigitalAudio.kicad_pcb]
2022-01-18 - Fix: no thermals auf GND Layer unter MAX
    [ReleaseDeviceDigitalAudio.kicad_pcb]
2022-01-19 - großes BOM update mit allen Bauteilen und Verfügbarkeiten geupdated
    [20220119 BOM TeKaDe Baseboard 5VEXT.xlsx]
2022-01-19 - update
    [20220119 BOM TeKaDe Baseboard 5VEXT.xlsx]
2022-01-20 - 1,5mm Connector aus BOM gestrichen, damit ist kein Platz für Bauteile unter CM4 - RTC neben das CM4 verschoben, da mit 1,75mm um 0,25mm zu hoch für unterhalb - BT1 von THT auf SMD Typ gewechselt (B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
    [7SegmentDriver.sch, BluetoothModule.sch, PowerSupplyCM4.sch, RTC.sch, ReleaseDeviceDigitalAudio.kicad_pcb]
2022-01-20 - merged Lib updates
    [RTC.sch, ReleaseDeviceDigitalAudio.kicad_pcb]
2022-01-20 - BOM update fehlte in letztem commit
    [20220119 BOM TeKaDe Baseboard 5VEXT.xlsx]
2022-01-20 Added logo + version number
    [ReleaseDeviceDigitalAudio.kicad_pcb]
2022-01-20 added logo, version
    [ReleaseDeviceDigitalAudio.kicad_pcb]
2022-01-21 - Gerber Export
    [ReleaseDeviceDigitalAudio-B_Cu.gbr, ReleaseDeviceDigitalAudio-B_Mask.gbr, ReleaseDeviceDigitalAudio-B_Paste.gbr, ReleaseDeviceDigitalAudio-B_SilkS.gbr, ReleaseDeviceDigitalAudio-Edge_Cuts.gbr, ReleaseDeviceDigitalAudio-F_Cu.gbr, ReleaseDeviceDigitalAudio-F_Mask.gbr, ReleaseDeviceDigitalAudio-F_Paste.gbr]
2022-01-31 - Testpoints für BM83 USB hinzugefuegt
    [BluetoothModule.sch, ReleaseDeviceDigitalAudio.kicad_pcb]
2022-02-18 - Reset IC fuer BM83 hinzugefuegt
    [20220218 BOM TeKaDe Baseboard 5VEXT.xlsx, BluetoothModule.sch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]
2022-03-22 - Schaltplan und BOM an BM64 angepasst
    [20220322 BOM TeKaDe Baseboard 5VEXT BM64.xlsx, AudioMixing.sch, BluetoothModule.sch, ReleaseDeviceDigitalAudio.kicad_pcb, ReleaseDeviceDigitalAudio.sch]
2022-03-30 Umbau auf BM64 zur Freigabe
    [20220322 BOM TeKaDe Baseboard 5VEXT BM64.xlsx, BluetoothModule.sch, ReleaseDeviceDigitalAudio.kicad_pcb]
2023-07-03 [add:] annotations, corrections from testing
    [7SegmentDriver.sch, AudioMixing.sch, BluetoothModule.sch, ControllerUIBoard.sch, LevelShift.sch, PowerSupplyCM4.sch, RTC.sch, RaspberryPiCM4.sch]
2023-11-09 all the changes before BSA21 project
    [PowerSupplyCM4.sch]
2023-11-09 first steps bsa31
    [ControllerUIBoard.sch]
2023-11-10 schematic changes up to layout import
    [AudioMixing.sch, BluetoothModule.sch, ControllerUIBoard.sch, LevelShift.sch, PowerSupplyCM4.sch, RTC.sch, RaspberryPiCM4.sch, ReleaseDeviceDigitalAudio.kicad_pcb]
